alexivan04/Pong-Stabilizer/docs/report/main_english_preview.pdf

# OctoBouncer

## Dynamic Balancing and Trajectory Control System

### Authors:

## Oana Datcu

Faculty of Mechanics and Mechatronics

## Ivan Alexandru

Faculty of Automatic Control and Computer Science

### Coordinators:

## Assoc. Prof. Dr. Eng. Daniel Rosner Eng. Teodor Dicu Teaching Assist. PhD Cand. Eng. Vlad St˘anescu

### Year 2026

# Contents

1 Introduction | 1

### 2 Mechanical Design and Hardware

Implementation | 2

2.2 Chassis Integration and Component

3 Mathematical and Kinematic Modeling | 14
4 Control Strategy | 17

5 Experimental Results and Conclusions | 27

# Chapter 1

# Introduction

The problem of balancing a spherical body on a flat surface, known in the specialized literature as “Ball and Plate” [1], is one of the complex problems in the field of control systems engineering. Although at first glance it seems a simple problem, it introduces an unstable nonlinear dynamics, in which any positioning error is affected by external factors. The OctoBouncer project, having as its source of inspiration the project of the same name [2], proposes a modern approach to this paradigm, extending the limits from simple stabilization to trajectory tracking, with the dynamic control of momentum (bouncing the ball) as the long-term goal. Our objective was not only to keep the ball at a fixed point, but to transform the platform into a system capable of complex interactions, such as complex trajectories.
This achievement required close collaboration between two fundamental disciplines:
- Mechatronics: Designing a platform driven by four arms, with three degrees of freedom (pitch, roll and height), characterized by low mass and high rigidity, capable of executing sudden vertical accelerations without compromising angular precision.
- Automatic Control: Developing a distributed control system, in which high-frequency image processing (Raspberry Pi 5 [3]) is closely tied to a real-time system (Teensy 4.1 [4]) in order to estimate the state of the ball and generate commands for the motors with minimal latency.

Through OctoBouncer, we demonstrate how feedback control algorithms and image processing can be integrated into a robust physical system, capable of holding the manipulated object at a fixed point and of moving it along predefined trajectories; managing its kinetic energy as well is the next step of the project.

# Chapter 2

# Mechanical Design and Hardware Implementation

The mechanical design of the OctoBouncer system evolved through an iterative process, with structural rigidity, efficient thermal management and easy maintenance as fundamental objectives. The chosen architecture is based on a redundant parallel robotic platform, a technical solution that offers a superior dynamic response compared to standard three-support-point configurations [13]. By using four independent actuation arms, the system manages to correct positioning errors in real time, ensuring increased stability of the platform plane even during translation movements, derived from the Stewart architecture [14].

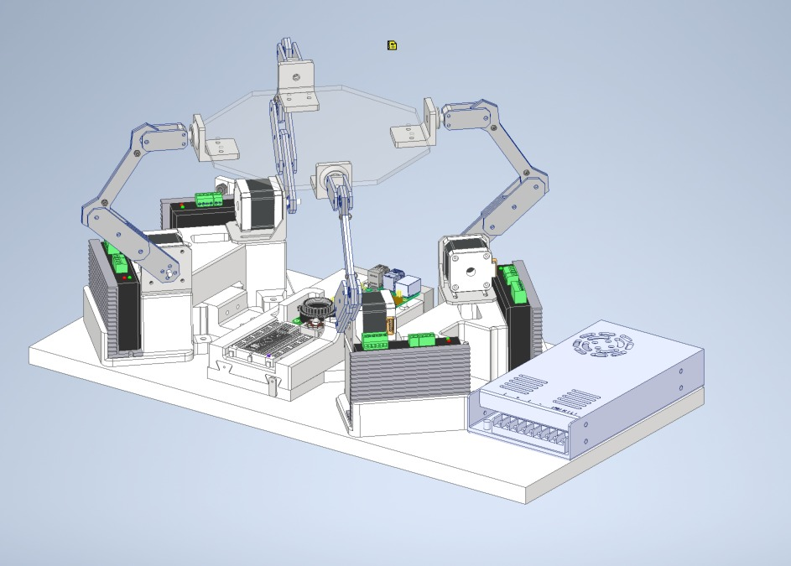
[picture p3: figure]

Figure 2.1: Isometric representation of the complete OctoBouncer system in the final design stage.

## 2.1 Anatomy of the Actuation Arm and Kinematic Optimization

The actuation arm is the most stressed component of the system, being designed to balance low mass with high mechanical strength. Its prototyping was carried out by 3D printing from PET-G [15], a material chosen for its superior impact resistance and its ability to maintain tight assembly tolerances. Each arm integrates a complex hybrid structure: one active joint connected directly to the motor and three free joints.
From a technical standpoint, the elimination of mechanical backlash was achieved by integrating precision bearings at each pivot point. This decision was critical in preventing parasitic vibrations that could have destabilized the control algorithm at high frequencies. An important innovation compared to previous versions was the introduction of an additional joint on a perpendicular plane, positioned at the point of contact with the platform. This modification solved the diagonal mobility limitations, allowing the platform to execute complex trajectories without geometric constraints.

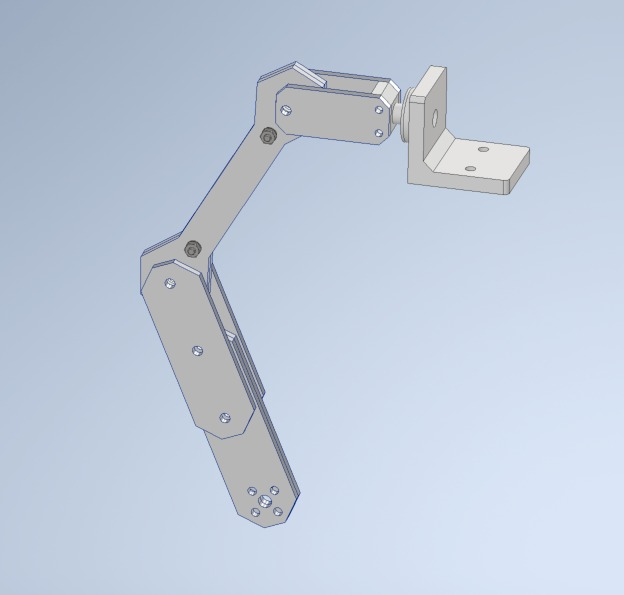
[picture p4: figure]

Figure 2.2: Arm detail: optimization of the joints and the perpendicular pivot point for extended mobility.

## 2.2 Chassis Integration and Component Management

The chassis of the system does not serve only as a structural support, but also as a casing and protection for the electronic components. The upper platform is made of 8 mm plexiglass. We opted for this thickness because it offers optimal inertia for stability, while also having elastic properties that favor the rebound function of the ball.
Beyond the mechanical aspects, a major challenge was thermal management. Stepper motors tend to generate high temperatures during prolonged operation, which could lead to structural deformation of the polymer parts. To counter this phenomenon, we used metal brackets that absorb and dissipate the motors’ heat, protecting the integrity of the PET-G base. Furthermore, the chassis design was provided with ventilation slots and dedicated air tunnels for the DM556 drivers [5], ensuring efficient active cooling under heavy loads.

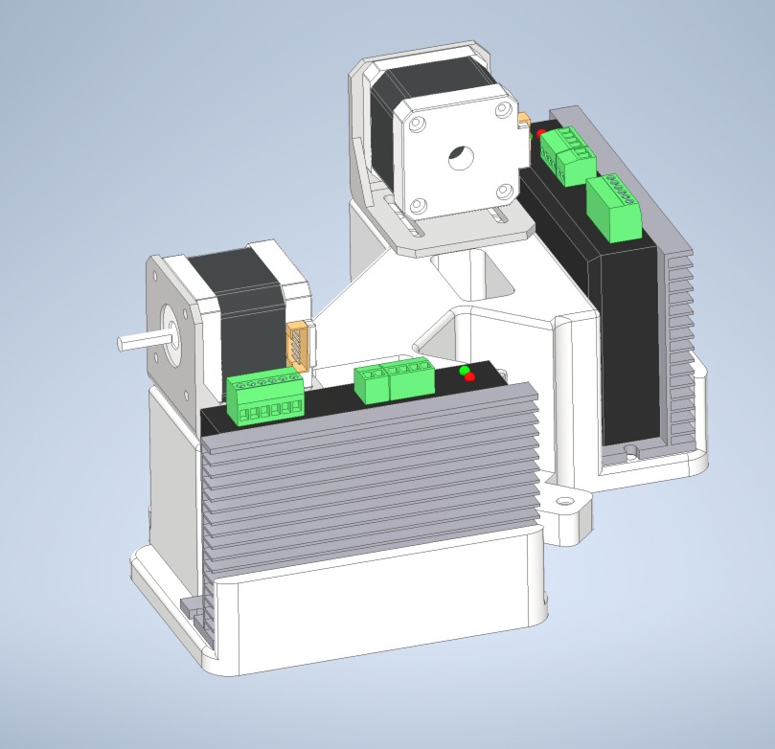
[picture p5: figure]

Figure 2.3: Internal section: airflow architecture and ergonomic layout of the power components.

Accessibility of the system was another priority in the design stage. We designed a slider-type system and interior channels for the efficient arrangement of the cables, facilitating quick access to the connections without the need to disassemble the arms. This approach reduces maintenance time and eliminates the risk of power or data wires interfering with the moving elements of the robot.

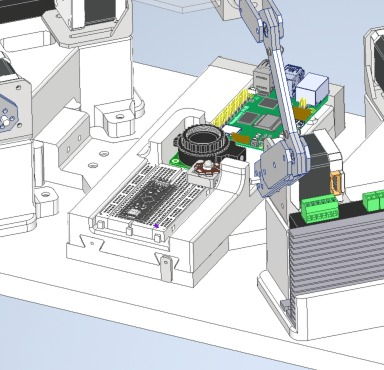
[picture p6: figure]

Figure 2.4: Detail of the sliding mechanism designed for quick access to the central computing unit and wiring.

## 2.3 Evolutionary Analysis of the Prototype

The transition from the initial version to the current OctoBouncer model involved a series of fundamental modifications. The first version suffered from low stability due to a center of mass that was too high and a lack of space for managing the wiring. The table below captures the technological evolution achieved between the two iterations.

Shortcomings of the Initial Version | Solutions Implemented in the Final Model
Robot too tall; instability under accelera-tion | Reduced profile to lower the center of mass
Difficult access to electronics; exposed wiring | Optimized chassis with slider system and protected channels
Thermal deformation of motor brackets | Integration of anti-deformation metal brackets
Limited mobility on certain axes | Addition of the perpendicular pivot joint

Table 2.1: Summary of the optimizations made to the mechanical design.

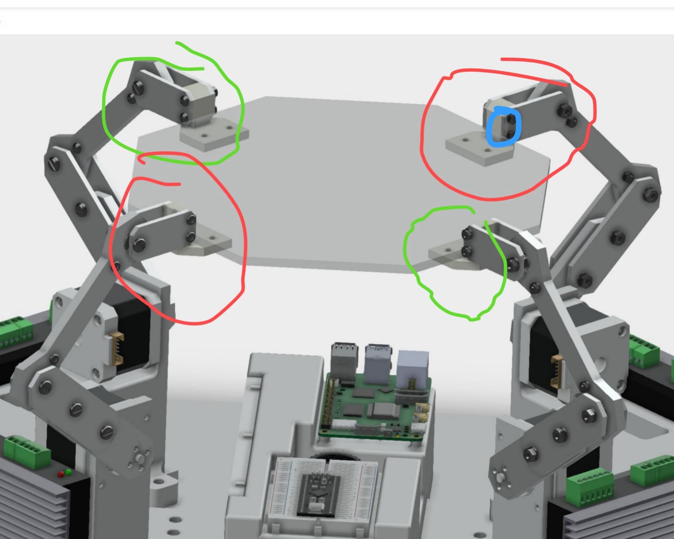
[picture p7: figure]
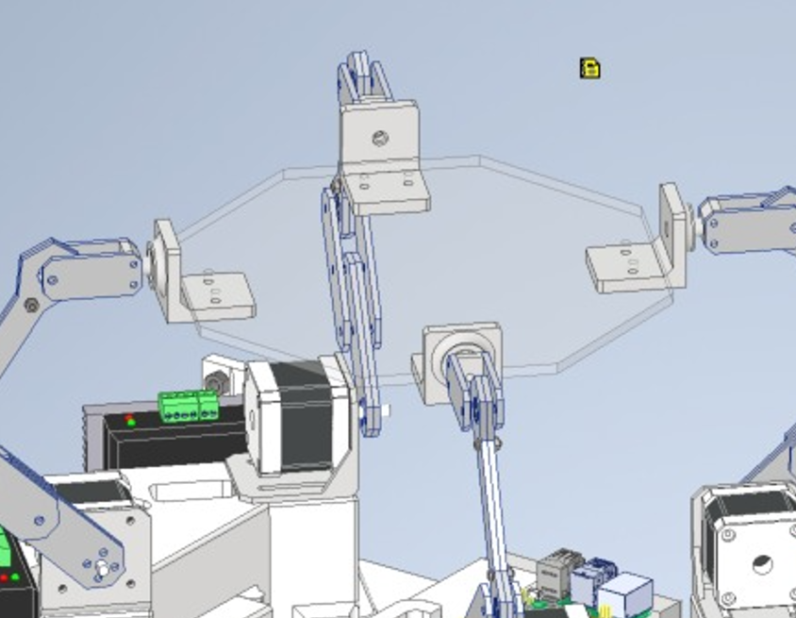
[picture p8: figure]

Figure 2.5: The initial prototype. | Figure 2.6: The OctoBouncer system.

## 2.4 Electronics and Connectivity

The electronic architecture of the OctoBouncer system was designed to ensure a minimal response time and high power supply stability, elements that are critical in the control of unstable systems. The system is built on a hierarchical structure, where the power supply for the high-power circuits and the logic one are separated in order to minimize electromagnetic interference (EMI).

### 2.4.1 Power Management

The main energy source is an efficient AC-DC unit, which provides a voltage of 48V. This value was chosen to power the power stages of the 4 DM556 drivers. The high

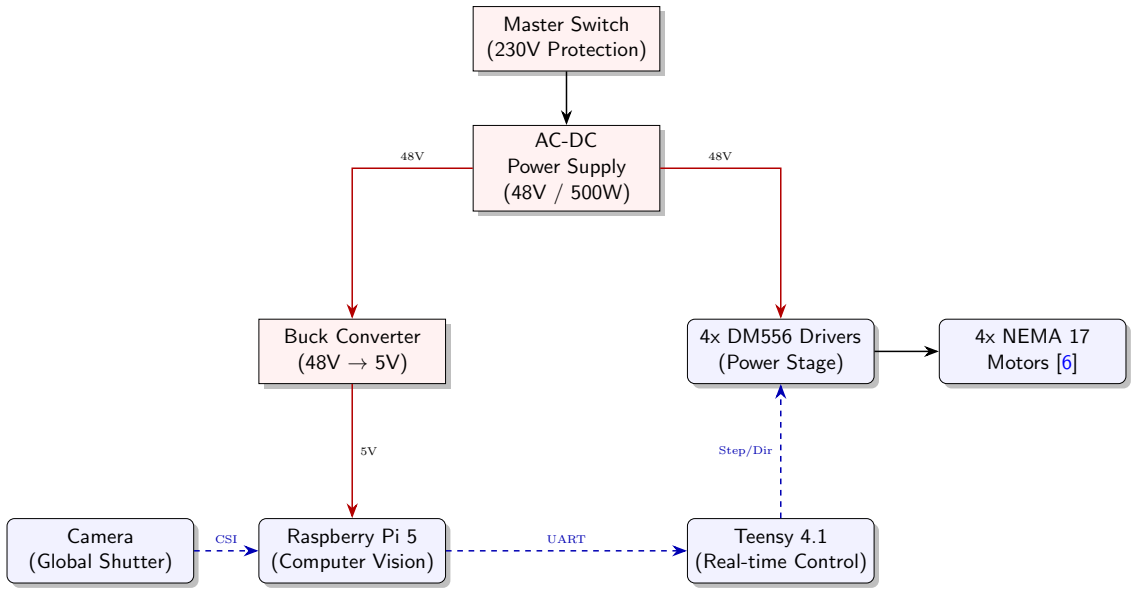
[picture p9: figure]
AC-DC Power Supply (48V / 500W); Master Switch (230V Protection); Buck Converter (48V → 5V); 4x DM556 Drivers (Power Stage); Raspberry Pi 5 (Computer Vision); Teensy 4.1 (Real-time Control); Camera (Global Shutter); 4x NEMA 17 Motors [6]; CSI; UART; Step/Dir

LED System
(Own 5V Supply)

Figure 2.7: Block diagram of the system.

voltage allows the stepper motors to reach high angular speeds and sudden accelerations, necessary for the ball’s “kick” phase, overcoming the torque limitations that usually appear at lower voltages (12V or 24V).
To power the logic subsystems, a Step-down converter lowers the voltage from 48V to 5V, in order to power the Raspberry Pi 5 and the camera. The DM556 drivers have no separate logic supply: their control electronics are powered from the 48V input.
The Teensy 4.1 (the main microcontroller) is supplied through its USB connection to the Raspberry Pi 5, which is also used to upload the firmware. The LED lighting has its own 5V step-down module, independent of the Raspberry Pi 5, and is always on. From the standpoint of safety during operation, the system integrates a high-power load switch placed directly on the input from the power supply. This switch fulfills the role of a safety barrier, allowing the instant disconnection of the entire assembly in the event of a mechanical or electrical failure, thus preventing damage to critical components or mechanical self-destruction in the event of a software error.

### 2.4.2 Actuation System and Motion Control

The control of the 4 stepper motors is carried out through industrial DM556 drivers, using Step/Dir. The motion is smoothed by configuring the drivers to a high microstepping regime (1/16, corresponding to 3200 steps/revolution). This high resolution eliminates mechanical vibrations, giving the platform millimeter-level precision in controlling the tilt plane.
Although the source code includes support for closed-loop feedback through magnetic encoders, the current version of the system uses open-loop control. The absence of encoders simplifies the wiring and reduces the computational latency, relying on the extremely stable frequency of the signal generated by the Teensy 4.1 to prevent step loss.

### 2.4.3 Communication and Data Flow

The interfacing between the two computing units is important for the best possible performance of the system:
- Camera interface: The camera communicates with the Raspberry Pi 5 through the dedicated CSI (Camera Serial Interface) port, ensuring a high-bandwidth data transfer and zero latency in the GPU’s processing buffer.
- Host-to-Controller: The Raspberry Pi 5 and the Teensy 4.1 communicate bidirectionally through the UART protocol at a speed of 115,200 baud. To guarantee the correctness of the data in an environment with electrical noise induced by the motors, a custom serial protocol was implemented. It contains the ball’s state vector (position and velocity on the 3 axes) in structured packets, validated through checksums, thus ensuring that no command is executed with corrupted data.

### 2.4.4 Electrical Schematic and Pin Assignment

Figures 2.8–2.11 show the complete electrical schematic, drawn in KiCad (the full sheet and the KiCad project are in the hardware/schematic folder of the repository). The pin numbers of the Raspberry Pi 5 are the physical pins of the 40-pin header; the pin numbers of the Teensy 4.1 are its digital pin numbers, as used in the firmware. The four motor channels are identical; the pins of each channel are given in Table 2.2.

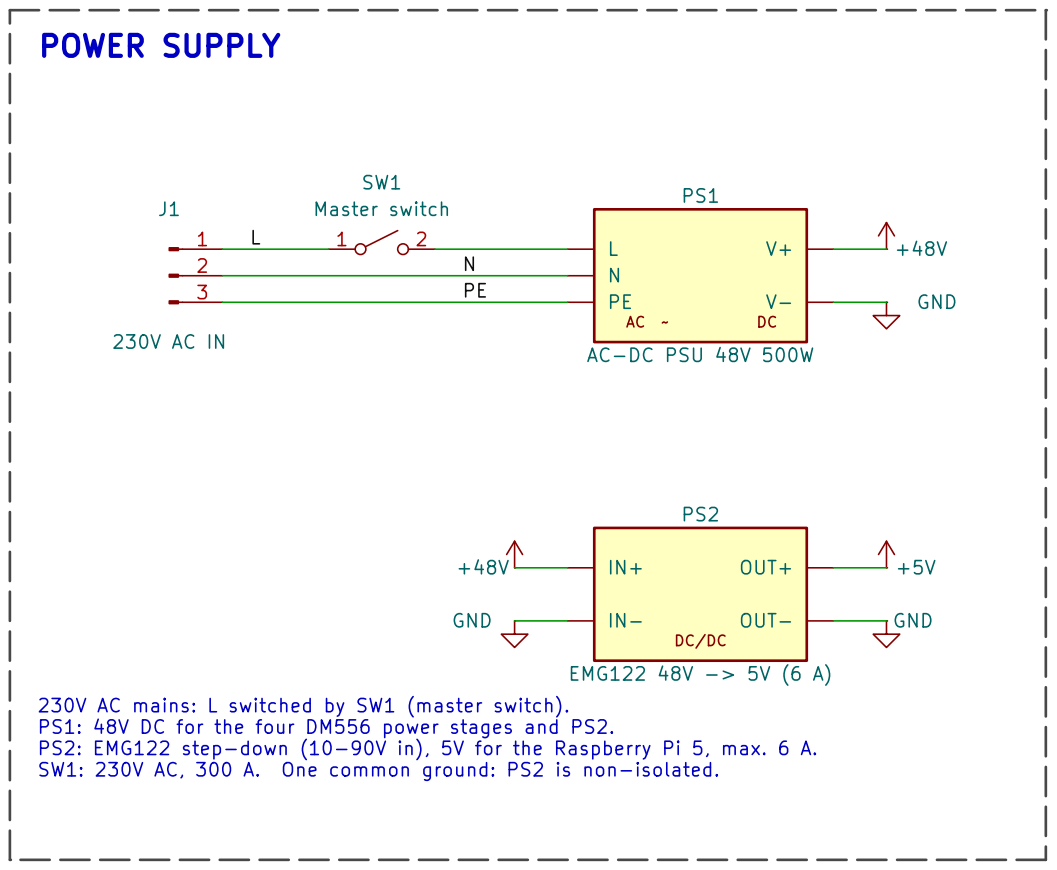
[picture p10: figure]

Figure 2.8: Electrical schematic, part 1 of 4: power supply.

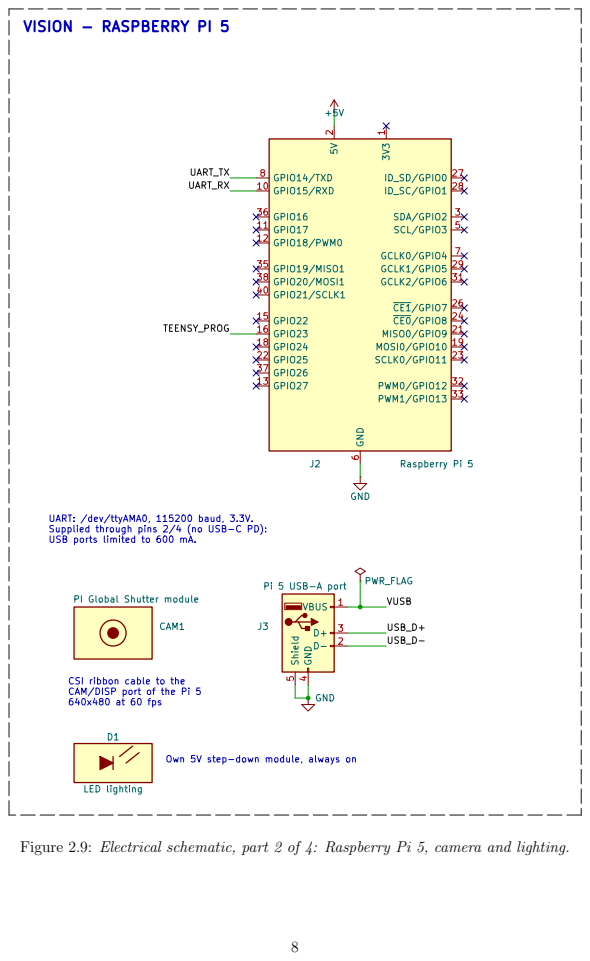
[picture p11: page 11]

Figure 2.9: Electrical schematic, part 2 of 4: Raspberry Pi 5, camera and lighting.

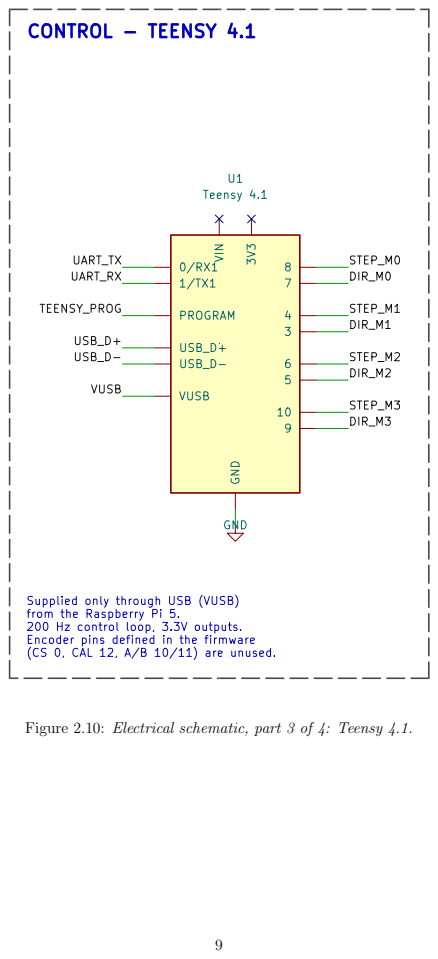
[picture p12: page 12]

Figure 2.10: Electrical schematic, part 3 of 4: Teensy 4.1.

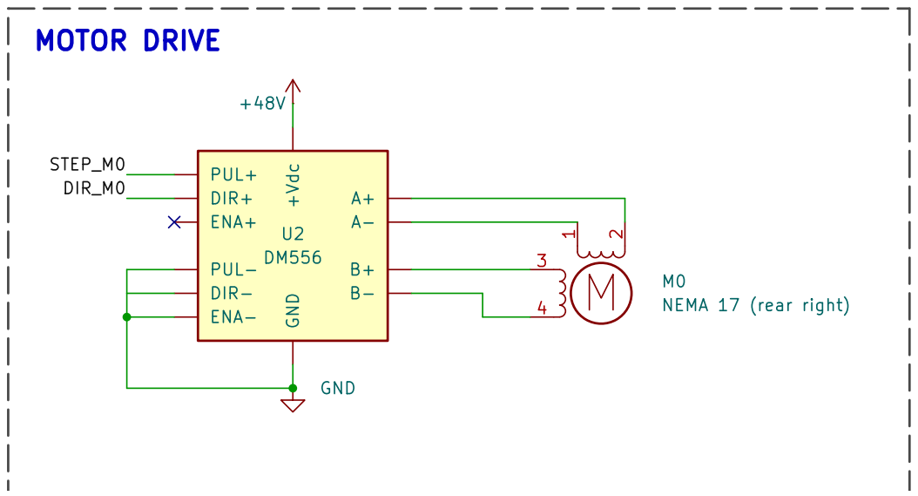
[picture p13: figure]

Figure 2.11: Electrical schematic, part 4 of 4: motor drive, channel M0. The channels M1–M3 are identical; their STEP and DIR pins are listed in Table 2.2.

Table 2.2 lists every connection of the schematic. The firmware also defines pins for the optional MT6835 magnetic encoders (CS on pin 0, CAL on pin 12, A/B on pins 10 and 11); since the encoders are not mounted in the current version, these definitions are inactive, and they would have to be moved to free pins before installing the encoders, because pin 0 is the UART receiver and pin 10 drives motor M3.

Signal | From | To | Notes
48V supply | PSU V+ / V− | DM556 +V / GND (all four), step-down IN+ / IN− | Power stage of the drivers
5V supply | Step-down OUT+ / OUT− | Pi 5 pins 2, 4 (5V) / pin 6 (GND) | Bypasses the USB-C input of the Pi
UART TX | Pi 5 pin 8 (GPIO14, TXD) | Teensy pin 0 (RX1) | /dev/ttyAMA0 → Serial1, 115,200 baud, 3.3V
UART RX | Pi 5 pin 10 (GPIO15, RXD) | Teensy pin 1 (TX1) | Direction: Teensy → Pi
Flash request | Pi 5 pin 16 (GPIO23) | Teensy PROGRAM | Puts the Teensy in bootloader mode
USB | Pi 5 USB-A | Teensy micro-USB | Only power source of the Teensy (5V), common ground, firmware upload
Camera | Pi 5 CSI port | Camera module | Ribbon cable
Lighting | Separate 5V step-down module | LED system | Independent of the Raspberry Pi 5, always on
STEP M0 / DIR M0 | Teensy pins 8 / 7 | DM556 M0 PUL+ / DIR+ | Motor M0, rear right
STEP M1 / DIR M1 | Teensy pins 4 / 3 | DM556 M1 PUL+ / DIR+ | Motor M1, front right
STEP M2 / DIR M2 | Teensy pins 6 / 5 | DM556 M2 PUL+ / DIR+ | Motor M2, front left
STEP M3 / DIR M3 | Teensy pins 10 / 9 | DM556 M3 PUL+ / DIR+ | Motor M3, rear left
Signal return | DM556 GND terminal | PUL−, DIR− and ENA− of each driver | Common-cathode wiring; the return reaches the Teensy ground through the common ground of the non-isolated step-down converter
Enable | – | DM556 ENA+ | Not connected (ENA− on GND): drivers always enabled
Motor phases | DM556 A+, A−, B+, B− | Motor coil A, coil B | One driver per motor

Table 2.2: Pin assignment of the electrical connections.

### 2.4.5 Component Ratings

Table 2.3 lists the electrical ratings of the components. The DM556 values are taken from the manufacturer’s manual [5], the Teensy 4.1 values from the PJRC specifications [4], and the Raspberry Pi 5 values from the product brief [3].

Component | Rating | Use in the system
AC-DC PSU | Output 48V DC, 500 W (max. 10.4 A) | Supplies the four drivers and the step-down converter
Master switch | 230V AC, 300 A, waterproof, ignition-protected | Disconnects the 230V AC input
Step-down converter | OEM EMG122 buck module: input 10–90V, output 1.5–60V (set to 5V), max. 6 A / 100 W, efficiency up to 97.5 % | Supplies the Raspberry Pi 5 (5 A recommended); non-isolated, so its input and output share the ground
Raspberry Pi 5 | 5V DC, 5 A recommended (27 W); GPIO 3.3V, not 5V tolerant | Image processing, UART master
Teensy 4.1 | 5V via USB, on-board 3.3V regulator; I/O 3.3V, not 5V tolerant | 200 Hz control loop, STEP/DIR generation
DM556 driver (×4) | Supply 20–50V DC; output 1.8–5.6 A peak, set to 2.7 A RMS (3.8 A peak) with the DIP switches; isolated logic inputs, 5V nominal | Microstepping 1/16 (3200 pulses/revolution)
NEMA 17 motor (×4) | ◦/step (200 Bipolar, 1.8 steps/revolution), rated 1.5 A per phase, 5 mm shaft [6] | Arm actuation
Camera | Raspberry Pi Global Shutter Camera (Sony IMX296 sensor) with fisheye lens, CSI, used at 640 × 480 and 60 fps | Ball detection
LED lighting | 5V, from its own step-down module | Constant illumination, always on

Table 2.3: Electrical ratings of the components.

Three aspects of these ratings are relevant for the operation of the system:

- Supply voltage margin: The 48V bus is close to the 50V maximum of the DM556 drivers. During fast deceleration the motors return energy to the bus, so the voltage can briefly rise above the nominal value; the margin of 2V should be kept in mind if the power supply is replaced.
- Logic levels: The optically isolated inputs of the DM556 are specified for 5V signals, while the Teensy 4.1 outputs 3.3V. In the current system they are connected directly; a 3.3V → 5V level shifter would restore the nominal input current of the optocouplers.

- Raspberry Pi 5 supply through the GPIO header: Because the Pi 5 is supplied through pins 2 and 4, it does not negotiate its power with a USB-C supply, and by default it limits the total current of its USB ports to 600 mA. This is sufficient for the Teensy 4.1, which is the only USB device.

# Chapter 3

# Mathematical and Kinematic Modeling

The kinematic model of the OctoBouncer system has the role of establishing a precise correlation between the Cartesian coordinate space (the position and orientation of the platform) and the joint space (the rotation angles of the 4 stepper motors). For this project, we implemented an inverse kinematics model based on the geometry of parallel systems with 4 support points, using the mathematical basis specific to parallel robots [13], derived from the architecture of the Stewart manipulator [14].

## 3.1 Geometric Parameters of the System

In the geometric calculations, we used the following constant dimensions, determined through CAD design and direct measurements:

- L1 (98.1 mm): Length of the arm fixed on the motor shaft.
- L2 (92.0 mm): Length of the transmission rod (intermediate link).
- L3 (54.0 mm): Vertical offset created by the joint under the platform.
- Rb (129.0 mm): Radius of the fixed base (distance from the center to the motor axis).
- Rp (110.0 mm): Radius of the mobile platform (distance from the center to the spherical joint).
- h0 (100.0 mm): Neutral operating height of the platform.

## 3.2 Inverse Kinematics Calculation

The purpose of the algorithm is to determine the motor angle αi

for each arm
i ∈ {0, 1, 2, 3}, starting from the orientation angles θpitch (pitch) and θroll (roll).

### 3.2.1 Determining the Position of the Anchor Points

Each motor is positioned at an angle γi relative to the central axis, defined in the source code as:
γ = {225◦

, 135◦

, 45◦

, 315◦
} | (3.1)

For a given orientation of the platform, the vertical height Zi of each joint on the platform is calculated by projecting the tilt angles onto the radial geometry:

Zi = h0 + Rp · (sin(θroll) · cos(γi) + sin(θpitch) · sin(γi)) | (3.2)

Taking into account the length of the joint L3, the vertical target for the transmission rod becomes Ztarget = Zi − L3.

### 3.2.2 Solving the Arm Geometry (Law of Cosines)

Solving the inverse kinematics for parallel manipulators is done by decomposing the system into independent kinematic loops (closed-loop vector equations) [13]. The problem reduces to a triangle formed in the vertical plane of each motor. The radial distance between the point on the base and the one on the platform is constant in horizontal projection:

Xof fset = |Rb − Rp| | (3.3)

The direct distance D between the motor axis and the spherical joint on the platform is:
D =

q
X²
of fset + Z

2
target | (3.4)

Applying the Law of Cosines in the triangle formed by L1, L2 and D, we obtain the interior angle β:
β = arccos
L

2

1 + D² − L

2
2
2 · L1 · D
(3.5)

The final rotation angle of the motor, αi

, is the sum of the base geometric angle and the correction β:
αi = arctan 2(Ztarget, Xof fset) + β | (3.6)

## 3.3 Implementation in the Control Loop

The complete model above is implemented in the firmware (the calculateArmAngle function) and describes the geometry of the mechanism. In the current version of the real-time loop, however, it is not called: for the small tilts needed for balancing, the relation between the tilt of the platform and the rotation of each arm is close to linear, so the controller uses a linear mixing of the two tilt commands. The PID outputs θpitch and θroll (Chapter 4) are expressed directly in degrees of arm rotation, and each arm receives:

αi = αh + σ

p
i

θpitch + σ

r
i
θroll | (3.7)

with the signs (σ

p
i

, σr
i

) equal to (+1, +1), (−1, +1), (−1, −1) and (+1, −1) for the motors M0 (rear right), M1 (front right), M2 (front left) and M3 (rear left), where αh is the common arm angle that sets the height of the platform (Section 4.7). A positive pitch command thus raises the rear arms and lowers the front ones, and a positive roll command raises the right side. All angles αi are measured from the mechanical low stop of the arms. This simplification avoids the trigonometric calculations in the 200 Hz loop; the gains of the PID controller absorb the constant ratio between arm rotation and platform tilt.

## 3.4 Mechanical Limitations and Constraints

For reasons of structural safety and to prevent collisions between links or the locking of joints (singularities), we implemented a strict software limitation of the tilt commands:

−12◦ ≤ θpitch,roll ≤ 15◦
(3.8)

In addition, every arm command is limited to the range 5◦ ≤ αi ≤ 40◦ above the low stop, so that the arms never press against the stop, and the common height angle αh is kept between 17◦ and 30◦

, which leaves 12◦ of tilt range below and 10◦ above. With only 10◦ below (the earlier setting), the lower arm reached its limit as soon as pitch and roll together asked for more than 10◦
, and stopped reacting.
These constraints keep the system in a zone of relative linearity and prevent the motors from being forced into extreme positions. At the moment, the bouncing function is disabled in order to protect the integrity of the rod-joint assembly under heavy dynamic loads, as it has not yet been tested sufficiently.

# Chapter 4

# Control Strategy

The control system of the OctoBouncer is distributed between two processing units, the final goal being to keep the ball in the center of the platform (or to follow a trajectory) by continuously adjusting the tilt plane.

## 4.1 Distributed Control Architecture

To maximize performance, we separated the processing tasks into two levels:

1. High Level: The Raspberry Pi 5 runs the image processing algorithms under OpenCV, extracting the (x, y) coordinates of the ball and calculating the velocity vectors (Vx, Vy) at a high frequency.
2. Execution Level: The Teensy 4.1 receives the data through UART and runs the PID control loop at a frequency of 200 Hz (5 ms), generating the Step/Dir signals for the motors.

## 4.2 PID Control Algorithm

The core of the stabilization is a Proportional-Integral-Derivative (PID) controller [11]. The calculation formula for the desired tilt angle (on each axis) is:

θ(t) = Kp · e(t) + Ki

·

Z t

0

e(τ )dτ + Kd · (Vball(t) − Vtarget(t)) | (4.1)

where e(t) is the difference between the filtered position of the ball and the target position. Where the components fulfill the following roles:

- Proportional Term (Kp): Reacts instantaneously to the ball’s position error relative to the target (the center of the platform or the current point of the trajectory).
- Integral Term (Ki): Eliminates steady-state errors caused by possible mechanical imperfections or residual tilts of the base. We implemented an anti-windup limitation of the integral to prevent saturation of the integrator.
- Derivative Term (Kd): Acts as a “brake” (damping). The velocities of the ball and of the target are estimated on the Teensy by differentiating their EMA-filtered positions (Section 4.4) and smoothing the result with a second EMA filter (α = 0.2), which attenuates the numerical noise of the differentiation [12]. The term acts on the velocity of the ball relative to the target: a ball that moves together with a moving target is not braked, while with a fixed target (CENTER mode) the term reduces to a derivative on the measurement, which avoids command jumps when the target changes. The velocity estimated by the Raspberry Pi is also transmitted, but is not used by the controller. Section 5.7 compares this form with a derivative acting on the ball’s own velocity.

## 4.3 Real-Time Image Processing Subsystem (Raspberry Pi)

The high level of the control architecture is implemented as a Python script running continuously on the Raspberry Pi 5, which can be launched automatically at startup. Its responsibility is to transform the stream of frames from the camera into a complete state vector of the ball, made up of three-dimensional position and velocities, transmitted in real time to the Teensy 4.1. The subsystem code is organized modularly, each script fulfilling a distinct role in the development and operation flow of the system.

### 4.3.1 Camera Calibration with Fisheye Lens

The camera used is a Raspberry Pi Global Shutter Camera: its sensor exposes all pixels at the same time, so a fast-moving ball is not distorted as with a rolling shutter. It is equipped with a fisheye (ultra-wide angle) lens, which, although it maximizes the field of view in order to cover the entire surface of the platform, introduces a pronounced radial distortion. Straight lines appear curved, and objects at the edge of the frame are scaled non-uniformly relative to the center. Using raw pixel coordinates in the position calculations would introduce unacceptable systematic errors into the control loop.
The calibration process takes place in two steps implemented in the camera calib module:
1. Capturing the calibration images (1 capture images.py): A checkerboard pattern with a grid of 9 × 7 squares (8 × 6 interior corners) is used. The operator presents the board in front of the camera at various angles and distances, saving one frame at each press of the ’s’ key, at the moment when the findChessboardCorners algorithm [16] visually confirms the complete detection. The calibration set used comprises 31 images, covering sufficient spatial variations to characterize the distortion across the entire sensor area.
2. Calculating the intrinsic parameters (2 calibrate calc.py): Based on the set of images, the cv2.fisheye.calibrate algorithm from OpenCV [7] is run, which determines the camera’s intrinsic matrix K and the fisheye distortion vector [8, 9] D (with 4 coefficients). The correction of the corners is carried out through cornerSubPix to a precision of 0.001 pixels. The resulting parameters are saved in a binary Numpy array file, cam calib fisheye.npz, loaded at every system startup.

Based on these parameters, two rectification tables (map1, map2) are generated through the cv2.fisheye.initUndistortRectifyMap function. The cv2.remap function applies a bilinear rectification on each captured frame, efficiently transforming the initial fisheye projection into a distortion-free plane-perspective image. The parameter balance = 1.0 ensures that the entire field of view is preserved without cropping, at the cost of some black edges at the corners.

### 4.3.2 Ball Color Calibration (1 tune color.py)

The detection of the ball is based on color segmentation in the HSV space [10], chosen instead of RGB for decoupling the hue information from lighting variations. Before the first use, or whenever the ball, the light source or the ambient environment changes, the interactive color calibration script must be run.
The graphical interface exposes six sliders, corresponding to the lower thresholds [Hmin, Smin, Vmin] and to the upper thresholds [Hmax, Smax, Vmax]. The values are adjusted in real time while simultaneously observing the original image and the resulting binary mask, with the aim of maximizing the white area corresponding to the ball and eliminating any false positives from the background. The camera is configured in manual mode (without auto-exposure and without automatic white balance), with the exposure time set to 20 ms (limited by the camera to the frame period of 16.7 ms at 60 fps) and the analog gain at 2.0. Upon pressing the ’q’ key, the calibrated values are saved in the hsv values.txt file and will be loaded automatically at subsequent startups.

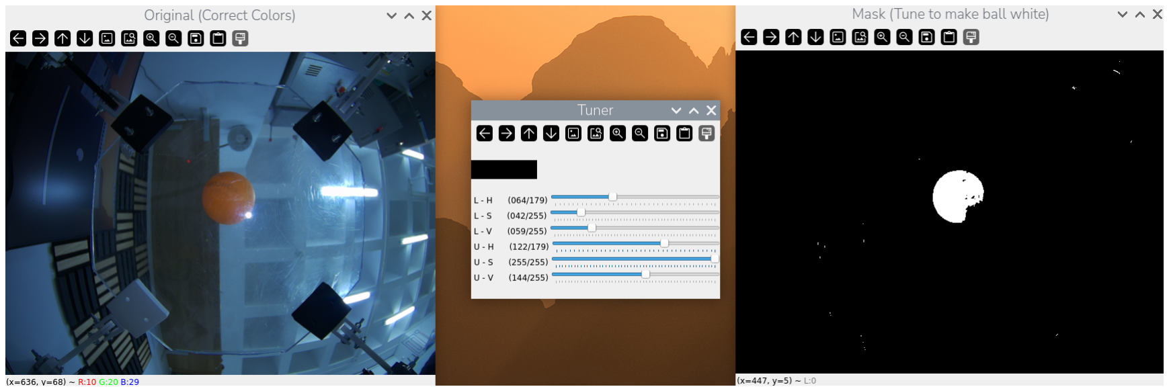
[picture p14: figure]

Figure 4.1: The HSV calibration interface: the original window (left), the slider panel with the current thresholds (center) and the resulting binary mask - the ball appears white, the background black (right).

### 4.3.3 Processing Pipeline and State Estimation

The main processing loop, implemented in 4 headless track.py (without display, for autonomous operation) and 4 gui track.py (with display, for monitoring and diagnostics), successively goes through the stages described below at an acquisition frequency of 60 fps, a resolution of 640 × 480 pixels, through the dedicated CSI interface of the Raspberry Pi 5.

1. Capture and geometric correction: The BGR frame is captured directly through the Picamera2 library [17] in native format, avoiding an additional color conversion. The precomputed fisheye rectification is applied immediately.
2. HSV segmentation and morphological operations: The corrected image is converted into the HSV space, and the binary mask is obtained through a color threshold. An erosion followed by a dilation with a 3 × 3 kernel is applied to the mask, eliminating point artifacts without affecting the geometry of the ball.
3. Contour selection and radius estimation: The cv2.findContours function extracts all the connected regions from the mask. The contour with the maximum area is selected as the sole candidate. The cv2.minEnclosingCircle function determines the center (xpx, ypx) and the radius rpx in pixels. A minimum threshold filter rpx > 5 eliminates false detections caused by reflections or other surrounding objects with similar hues.
4. 3D reconstruction through the corrected pinhole model: The depth Z is estimated from the apparent diameter of the ball in the geometrically corrected image, using an extended pinhole model with angular correction to compensate for the perspective elongation effect at the edges of the image:

Zpinhole =

fx · Dreal
2 · rpx

, Zf inal = Zpinhole ·

s
1 +
dcenter
fx

2
(4.2)

where Dreal = 40 mm is the real diameter of the ball, fx is the focal length extracted from the new camera matrix K′
, and dcenter is the distance in pixels from the optical center. The planar coordinates in millimeters are calculated through inverse projection:

Xreal =

(xpx − cx) · Zf inal
fx

, Yreal =

(ypx − cy) · Zf inal
fy

(4.3)

5. Plate-centered coordinates: The positions are finally expressed relative to the center of the plate, which lies (8.0, −1.2) mm from the optical center of the camera (measured once from markers on the brackets, with the plate level). The CENTER target and all patterns are therefore centered on the plate.
6. Median filtering of the depth: Because Xreal and Yreal are proportional to Zf inal, a single-frame error in the estimated radius would move the ball position and produce a false velocity. The depth is therefore passed through a median filter: the median of the last 15 frames (0.25 s) is used to scale X and Y , and the median of the last 5 frames is reported as Z. The median removes isolated outliers without smoothing real movements as strongly as an average.

### 4.3.4 Velocity Estimation and Two-Stage Filtering

Since the velocity of the ball cannot be obtained through direct measurement, it is estimated numerically. Differentiating the positions between consecutive frames amplifies the quantization errors, requiring a two-level filtering for noise attenuation:

1. Filtering the raw position (EMA with αpos = 0.6): Before computing the derivative, the raw positions are filtered. A higher α means that the system tracks the ball quickly, but passes more noise to the velocity estimation.
2. Filtering the calculated velocity (EMA with αvel = 0.15): The resulting numerical velocity is passed through an aggressive low-pass filter. The value αvel = 0.15 was determined experimentally: higher values (> 0.4) leave residual vibrations that destabilize the derivative term of the PID, while lower values (< 0.05) introduce a noticeable phase delay at sudden changes of direction.

These velocities are displayed in the diagnostic interface and transmitted to the Teensy, which computes its own estimate for the controller (Chapter 4). An additional deadband mechanism (1.5 mm) treats displacements that are below the threshold as null, eliminating false velocities under stationary-ball conditions. If the ball disappears from the field of view, the velocity is decremented exponentially (factor 0.8 per frame) instead of being reset abruptly, preventing command shocks at re-detection.

### 4.3.5 Tuning Parameters

The optimal functioning of the frame capture and processing subsystem depends on the correct calibration of the parameters grouped in the following table. They are adjustable both by directly modifying the source files and at runtime through the dedicated graphical interfaces.

Parameter | Current value | Impact when adjusted
[Hmin, Smin, Vmin] | [98, 145, 40] | Too narrow: detection losses; too wide: false posi-tives from the environment
[Hmax, Smax, Vmax] | [116, 255, 255] | Upper limit of the accepted color; Smax and Vmax at 255 include the entire brightness range
rpx,min (minimum radius) | 5 px | Below this value, the de-tection is ignored; prevents false positives from reflec-tions
αpos (position EMA) | 0.6 | Higher values: fast tracking, but more noise toward the velocity estimator
αvel (velocity EMA) | 0.15 | Compromise between atten-uating the derivative noise and the response latency at impact
Deadband | 1.5 mm | Eliminates velocity drift at rest; too large masks real slow movements
balance (undistort) | 1.0 | 0.0 = central crop without black edges; 1.0 = maxi-mum field of view preserved

Table 4.1: Configuration parameters of the visual detection subsystem and their effect on the behavior of the system.

### 4.3.6 Live Visualization and Diagnostic Interface

The versions with display (4 gui track.py, 4 gui track w mode.py) overlay a diagnostic layer on top of the corrected video stream, intended exclusively for tuning and debugging. The overlay displays the ball detection status (FOUND/LOST), the spatial coordinates (X, Y, Z) and the velocities (Vx, Vy, Vz) in real time, the green circle superimposed on the detected ball, the current operating mode of the system, as well as a real-time animation in the bottom-right corner.

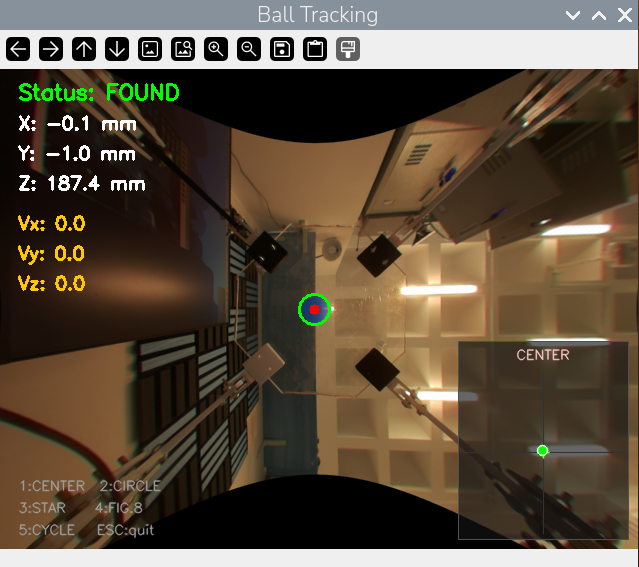
[picture p15: figure]

Figure 4.2: The GUI interface in CENTER mode: the ball is kept in the center of the platform, and the minimap indicates the target position (green) relative to the actual position of the ball (yellow).

### 4.3.7 Trajectory Generator and Pattern Selection

In addition to stabilization at a fixed point, the OctoBouncer system implements a trajectory generator that forces the ball to follow predefined geometric shapes. The active mode is controlled bidirectionally through the UART protocol: the Teensy 4.1 notifies the Raspberry Pi at each pattern transition, and the user can change the mode from the graphical interface by pressing the keys 1–5, without any need for a direct modification in the code.
Four distinct trajectories are defined, plus an automatic cycling mode:
- CENTER (key 1): The ball is kept at the origin of the platform. The target is fixed at (0, 0).
- CIRCLE (key 2): The ball follows a circular trajectory with a radius of 50 mm and a period of 5 s.
- STAR (key 3): A 5-pointed star-shaped trajectory, alternating between the outer radius of 60 mm and the inner one of 25 mm, with a period of 10 s.
- FIGURE 8 (key 4): A figure-eight-type trajectory (lemniscate), with a horizontal semi-axis of 60 mm and a vertical one of 30 mm, with a period of 6 s.

- CYCLE ALL (key 5): The system automatically cycles through all four modes above, 25 s each, with smooth transitions ensured by a target rate limiter of 120 mm/s.

Two further patterns, STEP X and STEP Y, are used only by the automated test protocol (Chapter 5): the target jumps between −30 and +30 mm along one axis every 8 s, through the same rate limiter.
The synchronization of the visualization with the real execution is ensured by transmitting the current target position (tx, ty) from the Teensy to the Raspberry Pi through a dedicated PACKET TYPE TARGET POS packet at every 5 ms iteration. Thus, the green dot in the animation reflects exactly the coordinate followed by the PID controller.

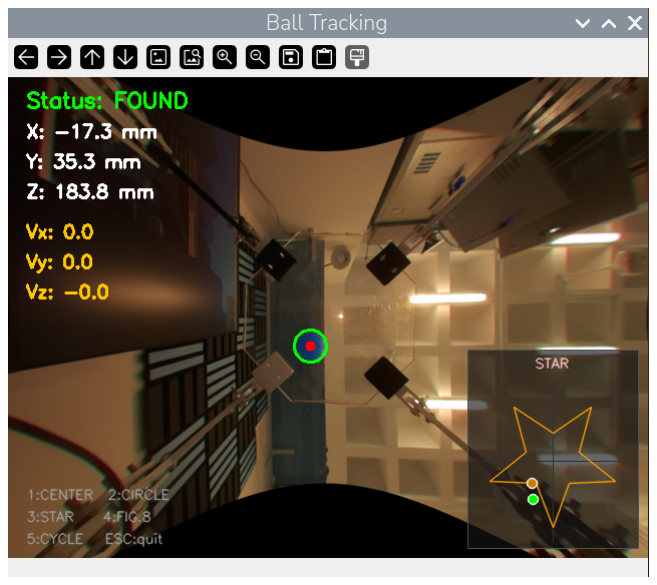
[picture p16: figure]
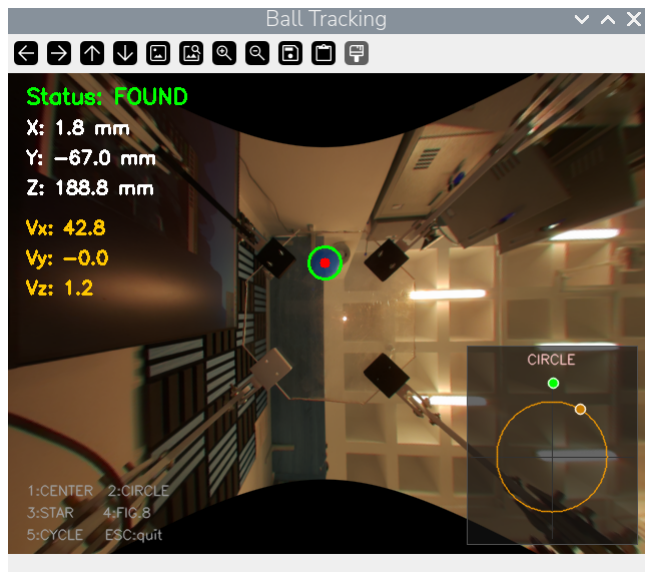
[picture p17: figure]
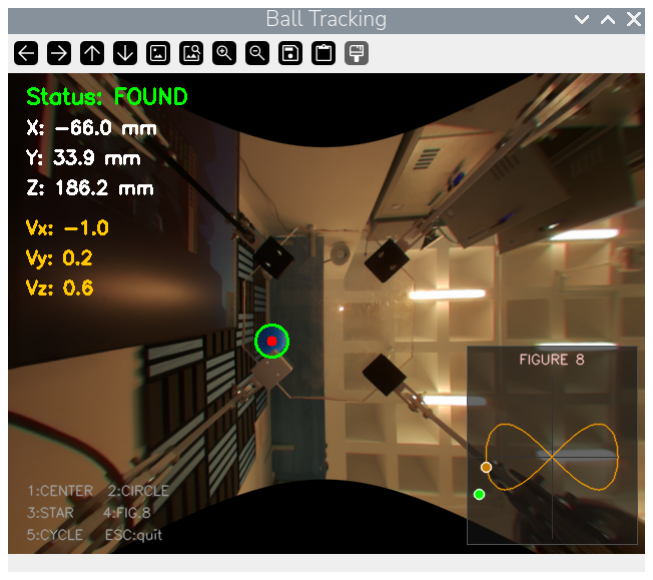
[picture p18: figure]

Figure 4.3: CIRCLE mode. | Figure 4.4: STAR mode. | Figure 4.5: FIG8 mode.

### 4.3.8 Real-Time PID Tuning Interface

The 4 gui track pid.py script extends the diagnostic interface with three sliders that allow adjusting the coefficients Kp, Ki and Kd in real time, without restarting the system. The sliders start from the default values hardcoded in the firmware (Kp = 0.149, Ki = 0.112, Kd = 0.068, for positions expressed in the units of the HSV pipeline; see Section 5.1). The values are scaled internally by the factor 1
| | 1000 and are transmitted to
the Teensy through a dedicated packet of type PACKET TYPE PID UPDATE once the user modifies any slider. The current coefficients are also displayed in the video overlay (in light green, under the velocities section).

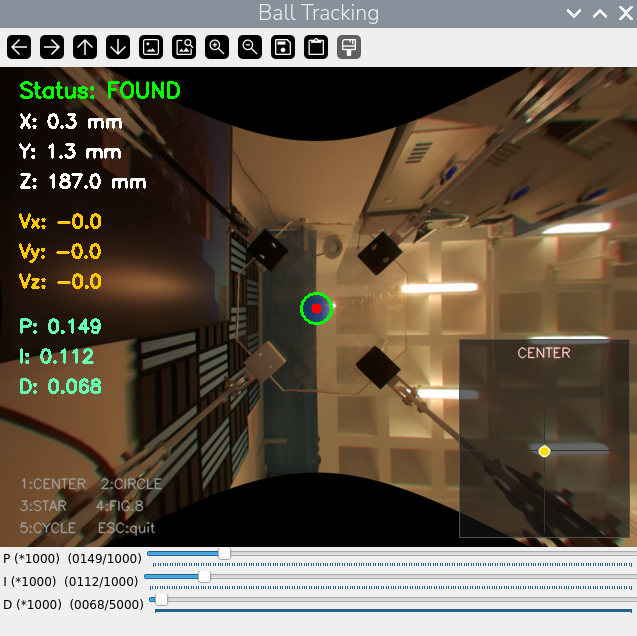
[picture p19: figure]

Figure 4.6: The PID tuning interface: the P, I, D sliders visible in the lower part of the window, with the current values displayed in the overlay (light green). Pattern selection remains available through the keys 1–5.

### 4.3.9 Serial Communication Protocol

At the end of each processing cycle, the ball’s state vector is serialized and transmitted through UART at 115,200 baud. The implemented custom protocol has the structure:

0xAA | {z }

start

| TYPE | {z }

packet type

| SIZE | {z }

length

| PAYLOAD | {z }

data

| CSUM | {z }

XOR

| 0xBB | {z }

stop

(4.4)

The checksum is calculated as an accumulated XOR over the packet type, the size and each byte of the payload. The checksum is validated on the Teensy before the data is introduced into the PID loop; a corrupted packet is ignored, and the system continues with the last valid state. Five packet types are defined: BALL DATA (the positions X, Y, Z and the velocities Vx, Vy, Vz packed as 6 32-bit floats, with a status byte is found), PID UPDATE (three floats with the new coefficients), START (initialization signal), PATTERN CHANGE (mode change, bidirectional) and TARGET POS (the current target position and the height setting of the platform, transmitted by the Teensy to the Pi at every 5 ms iteration for the synchronization of the minimap). The Teensy reads only the position and the detection status from BALL DATA.

## 4.4 Data Filtering (EMA Filter)

The received position data may exhibit white noise due to the camera resolution or lighting variations. To normalize the system’s response without introducing significant latencies, we used an EMA (Exponential Moving Average) filter [19]:

Xf iltrat = α · Xraw + (1 − α) · Xanterior | (4.5)

The value α = 0.15 was chosen experimentally to balance noise attenuation with the reaction speed of the system. The target position is passed through an identical filter before its velocity is computed, so that the two velocities compared in the derivative term have the same delay.

## 4.5 Real-Time Management and Synchronization

The stability of a “Ball and Plate” system depends on the constancy of the sampling period. The Teensy 4.1 uses a high-precision internal clock to ensure the execution of the control loop at exactly 5 ms. The firmware is written in C++ and built with PlatformIO [18].

- If the data from the Raspberry Pi is delayed, the system uses the last known state to maintain stability.
- The motor movement is interpolated to avoid mechanical shocks, ensuring a smooth transition between the calculation steps of the PID.

## 4.6 Safety Limitations (Software Constraints)

To protect the mechanical structure, the angles calculated by the PID are passed through a limiting block before being converted into arm commands (Section 3.3), and every arm command is limited to its safe range. This prevents reaching the mechanical limits of the joints in the case of violent movements or if the ball accidentally leaves the platform.
An edge guard protects the ball itself: when it moves more than 85 mm from the center of the plate, close to the edge and to the screws of the brackets, the target is moved back to the center (through the rate limiter) until the ball is again within 40 mm; then the pattern continues.

## 4.7 Plate Height Control

The arm angles are measured from the mechanical low stop, so the arms must rest on the stop when the Raspberry Pi sends the START command. At startup the Teensy lifts all arms to 5◦

in 1 s, then raises them together at 2◦/s to 17◦ while the balancing loop is already active, so the ball can be placed on the platform immediately.
From there, the common height angle αh is controlled from the measured depth of the ball: since the camera is under the platform, a higher platform increases Z. The Teensy keeps the ball at Z = 195 ± 4 mm by moving αh at 0.05◦/s per millimeter of error, at most 2◦/s, within the range 17◦–30◦
. The depth is low-pass filtered and only used while the ball is within 75 mm of the center, where its estimate is reliable. The height setting is reported to the Raspberry Pi in the TARGET POS packet.

# Chapter 5

# Experimental Results and Conclusions

## 5.1 Experimental Method

We measured the performance of the OctoBouncer on the physical system in two test campaigns. Both use the final control configuration: median-filtered depth, a derivative term acting on the velocity of the ball relative to the target, and closed-loop control of the plate height.

- Campaign A (24 October 2026): four runs (runs 7–10) in the automatic cycling mode (CYCLE ALL), in which the controller follows each pattern for 25 s: CENTER, CIRCLE, STAR and FIGURE 8. The ball was placed on the plate at start-up and the system was not touched afterwards. A fifth run (run 1), recorded with the same vision system but before the control changes (derivative term on the ball’s own velocity, depth not filtered), serves as the reference for the comparison of the two derivative terms in Section 5.7.
- Campaign B (25 October 2026): an automated test protocol (5 test runner.py) ran five times in a row, 42.6 min and 153,380 frames at 60 fps in total. Each run consists of 60 s in CENTER, 64 s of target steps along each axis (Section 5.4), 60 s of each pattern and five light taps on the ball held in CENTER (Section 5.5). Every test starts from the ball at rest after 10 s in CENTER, so all transitions are the same. The ball fell off once and was put back; the interrupted phase was repeated automatically.

Campaign B differs from campaign A in three details, introduced between the two: the positions are relative to the center of the plate instead of the camera (Section 4.3), the edge guard is active, and the tilt range is that of Section 3.3 (in campaign A: −10◦

to 15◦
,
and a minimum height of 15◦
). Only the final derivative term was tested in campaign B. In these runs the ball positions are expressed in true millimeters. The HSV pipeline of Section 4.3 reports about 1/1.4 of the true distances, because the dilated mask overestimates the apparent radius of the ball; the PID gains of Chapter 4 were therefore divided by the same factor 1.4, so that the controller behaves identically.
For every camera frame (60 Hz) the tracking script on the Raspberry Pi 5 logs the measured ball position pball(t) and the target ptarget(t) that the Teensy 4.1 reports through the TARGET POS packet every 5 ms, i.e. exactly the set-point used by the PID controller. All coordinates are in millimeters, relative to the camera’s optical center in campaign A and to the center of the plate in campaign B. In campaign B every frame also carries its exposure time (the camera’s SensorTimestamp); the ball position is evaluated at that instant and the target is interpolated to it, so the delay between exposure and processing

(25.3 ms, median) does not appear as lag. The tracking error is defined as:

e(t) = ∥pball(t) − ptarget(t)∥ | | (5.1)

The following quantities were computed for each pattern phase:

- Steady-state error: The mean, RMS, 95th percentile (P95) and maximum of e(t) over the last 15 s of each 25 s phase. The final 0.5 s of each phase are excluded, because the target already moves towards the next pattern.
- Settling time (ts): The time after the pattern switch from which the 1 s moving RMS of e(t) stays below 1.1 times the largest 1 s moving RMS observed in the steady-state window. A value of zero means that the switch produced no error transient larger than the pattern’s own steady-state error.
- Lag: The time shift of the measured path that minimizes its mean squared distance to the target (positive: the ball is behind the target; negative: ahead of it).
- Shape deviation and amplitude ratio: The mean distance of the measured path from the ideal curve, and the ratio between the ball’s mean distance from the center and the target’s.
- Step response (campaign B): for each 60 mm step, the rise time from 10 to 90 % of the step, the delay between the 50 % points of target and ball, the overshoot, and the settling time to ±5 % of the step (3 mm) and to ±2 mm, measured from the start of the target ramp.
- Disturbance rejection (campaign B): the largest distance of the ball from the center after a tap, and the time until it stays within 5 mm of the center for at least 1 s.

In campaign B the steady state of the patterns is the window from 20 to 60 s after the start, and CENTER is evaluated from 5 s after the start.
Two checks support the validity of the measurement. First, the commanded target coincides with the mathematical trajectories of Section 5.2 (maximum deviation 0.07 mm), so the target rate limiter is not active in steady state and the comparison with the ideal curves is exact. Second, while the ball is held at the center, the high-frequency scatter of the measured position (deviation from its 0.25 s moving average) is 0.57 ± 0.12 mm RMS, an order of magnitude below the tracking errors reported below. The ball path is measured by the same vision system that closes the control loop; no independent ground-truth sensor was available.

## 5.2 Trajectory Tracking

The target trajectories are defined in the firmware of the Teensy 4.1 as:

CIRCLE: xt = 50 cos(ωt), yt = 50 sin(ωt), | ω = 2π/5 rad/s | (5.2)
FIGURE 8: xt = 60 sin(ωt), yt = 30 sin(2ωt), | ω = 2π/6 rad/s | (5.3)

and, for the STAR, as straight segments between ten vertices at the angles φi = π/2 +iπ/5 with radii alternating between 60 mm and 25 mm, covering one vertex per second (period 10 s). All values are in millimeters.

Figure 5.1 compares these curves with the measured ball paths in steady state, and Figure 5.2 shows the same data as time series.

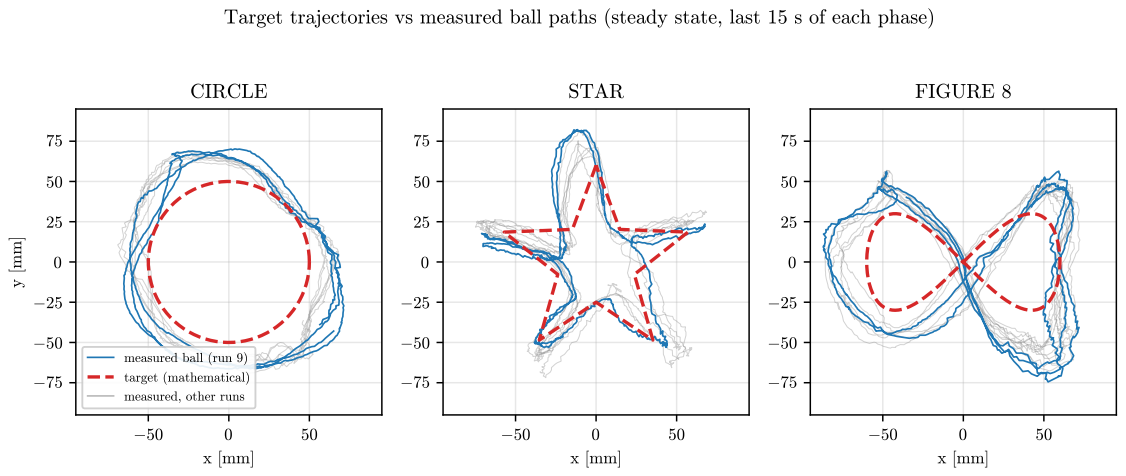
[picture p20: figure]
CIRCLE; measured, other runs; STAR; FIGURE 8

measured ball (run 9) target (mathematical)

Target trajectories vs measured ball paths (steady state, last 15 s of each phase)

Figure 5.1: Target trajectories (red, dashed) and measured ball paths in steady state (last 15 s of each phase). Blue: run 9; gray: runs 7, 8 and 10.

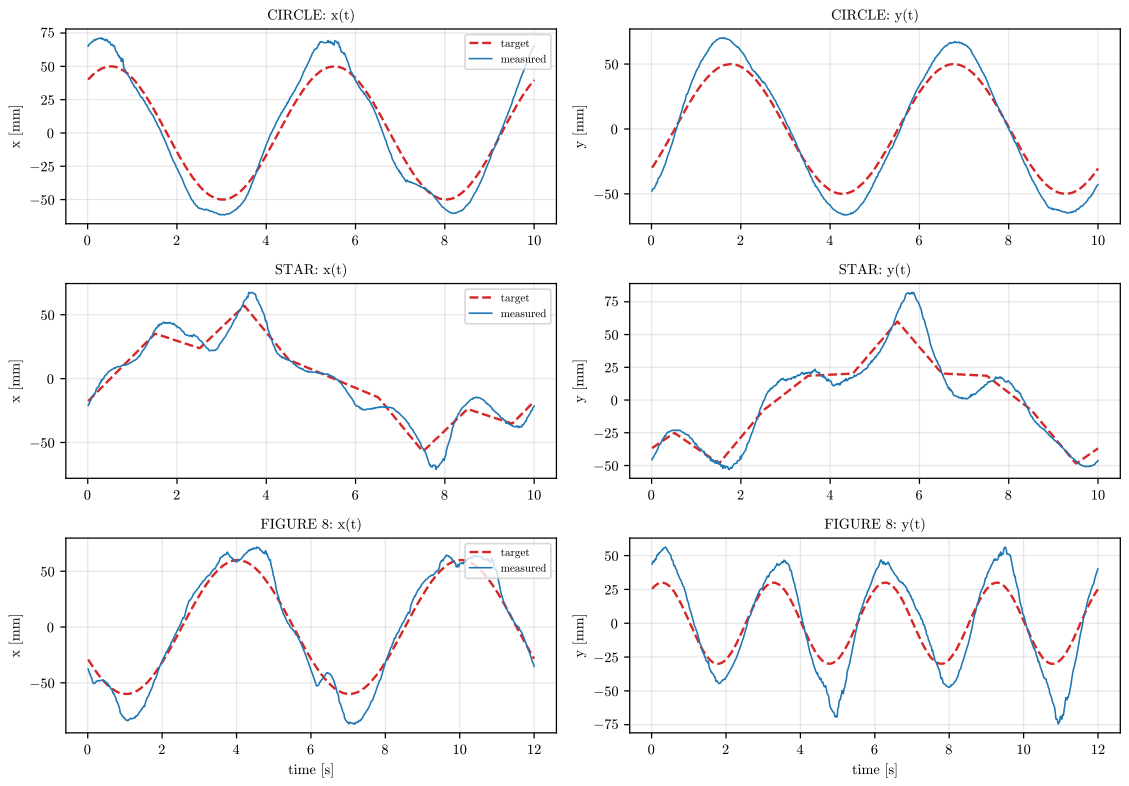
[picture p21: figure]
CIRCLE: x(t); target; measured; CIRCLE: y(t); STAR: x(t); STAR: y(t); time [s]; FIGURE 8: x(t); FIGURE 8: y(t)

Figure 5.2: Target (red, dashed) and measured (blue) coordinates over time, run 9, steady state.

The ball follows all three shapes with almost no time lag (Table 5.1): 0.05 s on the figure 8 and 0.10 s on the star, while on the circle it is even 0.04 s ahead of the target

(negative lag). This is a consequence of the derivative term acting on the velocity relative to the target: it reacts to the motion of the target itself and produces a phase lead, which compensates the delay of the plate and of the ball. The price of this lead is an overshoot in amplitude, so the remaining error is mostly geometric: the ball travels on a path that is larger than the target, by 25 % on the circle and 31 % on the figure 8, overshooting outwards where the curvature is highest. The star, made of straight segments covered at low speed, is followed most faithfully: its measured path stays on average 7.4 mm from the ideal shape and is only 9 % larger, the extra displacement appearing mainly at the outer vertices.

Pattern | Lag [s] | RMS without lag [mm] | Shape devia-tion [mm] | Amplitude ra-tio
CIRCLE | −0.04 ± 0.01 | 15.0 ± 1.6 | 12.8 ± 1.6 | 1.25 ± 0.03
STAR | 0.10 ± 0.02 | 13.5 ± 0.7 | 7.4 ± 0.6 | 1.09 ± 0.01
FIGURE 8 | 0.05 ± 0.02 | 18.5 ± 1.4 | 13.7 ± 1.1 | 1.31 ± 0.03

Table 5.1: Decomposition of the tracking error on the moving patterns: time lag, error without the lag, deviation from the ideal shape and amplitude ratio.

Campaign B repeats the three patterns five times each, always starting from the ball at rest (Table 5.2, Figure 5.3). The mean errors, 14.2 mm (circle), 14.6 mm (star) and 16.5 mm (figure 8), are practically those of campaign A, and the spread between the five runs is only 0.5–1.0 mm. With the exposure time of each frame the lag is free of the camera delay: the ball is 0.08 s ahead of the target on the circle, 0.11 s behind on the star and 0.03 s behind on the figure 8; the amplitude ratios (1.24, 1.09 and 1.29) confirm the outward deviation found in campaign A.

Metric | CIRCLE | STAR | FIGURE 8
Settling time [s] | 2.1 ± 1.4 | 1.6 ± 3.2 | 0.5 ± 1.1
Mean error [mm] | 14.2 ± 0.5 | 14.6 ± 1.0 | 16.5 ± 0.6
Mean error without screw contacts [mm] | 14.2 ± 0.5 | 14.5 ± 1.1 | 15.7 ± 0.8
P95 error [mm] | 23.4 ± 1.0 | 27.8 ± 2.0 | 28.8 ± 1.3
Lag [s] | −0.08 ± 0.01 | 0.11 ± 0.02 | 0.03 ± 0.01
Amplitude ratio | 1.24 ± 0.01 | 1.09 ± 0.02 | 1.29 ± 0.01
Shape deviation [mm] | 12.2 ± 0.5 | 7.3 ± 0.5 | 12.6 ± 0.4
Screw contacts per run | 0.4 ± 0.5 | 2.0 ± 1.1 | 12.4 ± 2.9

Table 5.2: Trajectory tracking in campaign B (5 runs per pattern, each started from the ball at rest in CENTER); steady state 20–60 s; lag from the exposure time of each frame (camera delay removed); without screw contacts: excluding 0.3 s around each contact.

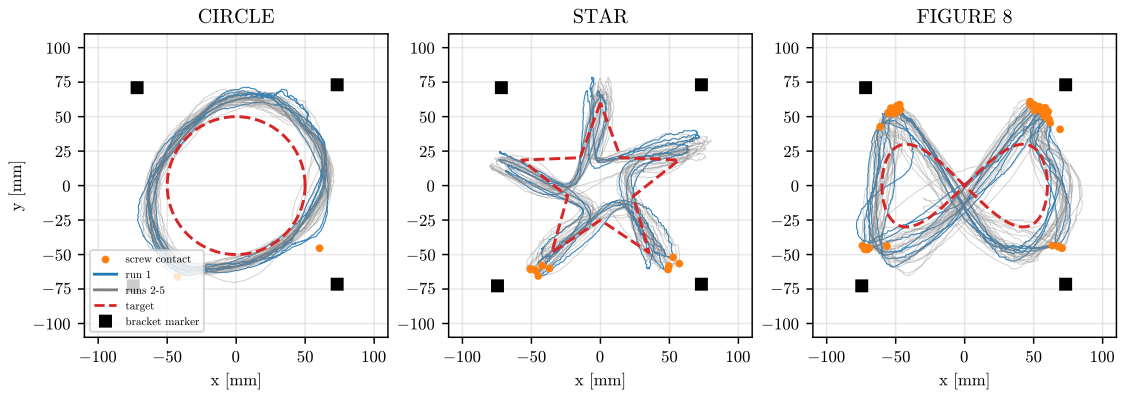
[picture p22: figure]
CIRCLE; screw contact run 1; runs 2-5 target bracket marker; STAR; FIGURE 8

Figure 5.3: Campaign B: target trajectories (red, dashed) and measured ball paths in steady state, run 1 (blue) and runs 2–5 (gray), with the detected screw contacts (orange) and the bracket markers (black).

## 5.3 Settling Time and Steady-State Error

Table 5.3 summarizes the settling time and the steady-state tracking error. Figure 5.4 shows the error over a complete pattern cycle, and Figure 5.5 the behavior after switching to CENTER.

Pattern | Runs | Settling [s] | Mean [mm] | RMS [mm] | P95 [mm] | Max [mm]
CENTER | 3 | 4.6 ± 4.1 | 2.9 ± 1.5 | 3.4 ± 1.8 | 7.0 ± 4.0 | 8.4 ± 4.2
CIRCLE | 3 | 2.2 ± 0.7 | 14.2 ± 1.5 | 15.3 ± 1.5 | 24.3 ± 1.2 | 29.1 ± 1.9
STAR | 4 | 2.4 ± 1.8 | 12.5 ± 0.9 | 14.4 ± 1.0 | 26.7 ± 2.8 | 33.8 ± 3.4
FIGURE 8 | 4 | 0 | 17.1 ± 1.2 | 18.9 ± 1.5 | 30.6 ± 5.3 | 41.7 ± 6.5

Table 5.3: Settling time and steady-state tracking error of the final configuration (mean ± standard deviation over the runs).

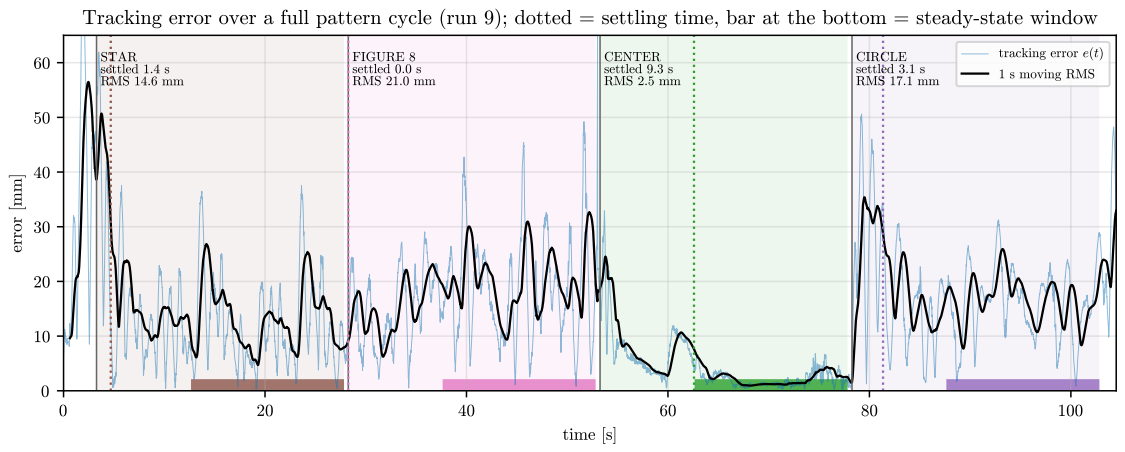
[picture p23: figure]
time [s]; error [mm]; STAR; FIGURE 8; CENTER; CIRCLE; tracking error e(t)

settled 1.4 s RMS 14.6 mm | settled 0.0 s RMS 21.0 mm | settled 9.3 RMS 2.5 mm | s | settled 3.1 s RMS | 1 s moving RMS 17.1 mm

Tracking error over a full pattern cycle (run 9); dotted = settling time, bar at the bottom = steady-state window

Figure 5.4: Tracking error over one complete pattern cycle (run 9). Thin line: e(t); thick line: 1 s moving RMS; dotted lines: settling time of each phase; colored bars at the bottom: steady-state window.

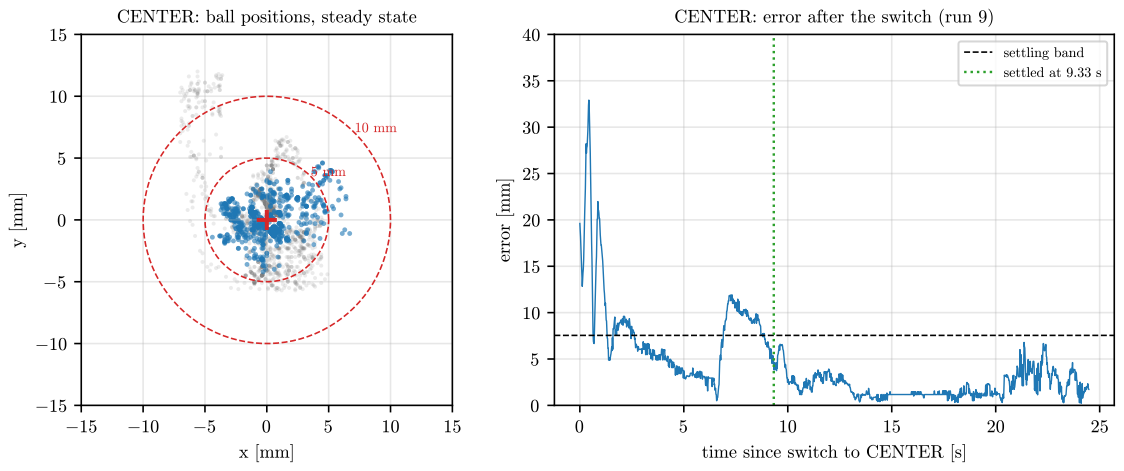
[picture p24: figure]
CENTER: ball positions, steady state; time since switch to CENTER [s]; error [mm]; CENTER: error after the switch (run 9); settling band settled at 9.33 s

Figure 5.5: CENTER mode. Left: ball positions in steady state (blue: run 9, gray: runs 7 and 8). Right: tracking error after the switch to CENTER in run 9, with the settling band.

When the target is fixed at the center, the ball is held with a mean error of 2.9 ± 1.5 mm. In steady state it stays within 5 mm of the center in 97 % and 96 % of the samples in runs 8 and 9, and in 65 % in run 7, where it stays within 10 mm in 90 % of the samples. The transition into CENTER (the target returns from the previous pattern at the 120 mm/s rate limit) settles in 2.1 s and 2.5 s in runs 7 and 8. In run 9 the settling time is 9.3 s, because of a single excursion of about 12 mm, 7 s after the switch (Figure 5.5, right), whose cause was not identified; for this reason the per-run values are listed in Table 5.5 in addition to the mean. Switching to CIRCLE or STAR settles within 2.2 ± 0.7 s and 2.4 ± 1.8 s. Switching from STAR to FIGURE 8 produced no transient beyond the figure 8’s own steady-state error in any of the four runs.
On the moving patterns the steady-state error is 12.5 mm (star), 14.2 mm (circle) and 17.1 mm (figure 8) on average, with 95 % of the samples below 26.7, 24.3 and 30.6 mm respectively. The spread between runs is small (standard deviation

0.9–1.5 mm on the mean error), which indicates that these values are repeatable. The ball was detected in 100 % of the analyzed frames.
In campaign B, started from the ball at rest, the patterns settle within 2.1 ± 1.4 s (circle), 1.6±3.2 s (star) and 0.5±1.1 s (figure 8). In CENTER the ball is held with a mean error of 2.3 ± 0.7 mm and stays within 5 mm of the center during 92 ± 6 % of the time (81–100 % in the individual runs), with a measurement noise of 0.33 mm (Table 5.4). The lower error than in campaign A (2.9 mm) is consistent with the plate-centered coordinates, which hold the ball in the middle of the plate instead of 8 mm to the side of it.
Runs | Mean [mm] | RMS [mm] | P95 [mm] | Max [mm] | Within 5 mm | Noise [mm]
5 | 2.3 ± 0.7 | 2.8 ± 0.8 | 5.6 ± 1.7 | 9.1 ± 3.5 | 92 ± 6 % | 0.33 ± 0.07

Table 5.4: CENTER hold after the ball was placed at rest (60 s per run, first 5 s excluded).

Run | Pattern | Settling [s] | Mean [mm] | RMS [mm] | P95 [mm] | Max [mm]
7 | CENTER | 2.08 | 4.7 | 5.5 | 11.6 | 13.2
7 | CIRCLE | 1.78 | 13.5 | 14.5 | 23.3 | 27.8
7 | STAR | 5.05 | 11.6 | 13.2 | 23.4 | 29.7
7 | FIGURE 8 | 0.00 | 15.8 | 17.4 | 26.5 | 33.6
8 | CENTER | 2.45 | 1.9 | 2.4 | 4.7 | 5.3
8 | CIRCLE | 1.85 | 13.2 | 14.4 | 23.8 | 28.4
8 | STAR | 1.75 | 13.8 | 15.5 | 27.9 | 32.4
8 | FIGURE 8 | 0.00 | 17.4 | 19.0 | 28.4 | 40.9
9 | CENTER | 9.33 | 2.1 | 2.5 | 4.7 | 6.8
9 | CIRCLE | 3.08 | 16.0 | 17.1 | 25.7 | 31.3
9 | STAR | 1.41 | 12.2 | 14.6 | 29.9 | 37.6
9 | FIGURE 8 | 0.00 | 18.6 | 21.0 | 38.4 | 49.2
10 | STAR | 1.50 | 12.4 | 14.1 | 25.6 | 35.4
10 | FIGURE 8 | 0.00 | 16.5 | 18.2 | 29.1 | 43.3

Table 5.5: Settling time and steady-state tracking error for each run.

## 5.4 Step Response

Figure 5.6 and Table 5.6 show the response to 74 target steps of 60 mm (from −30 to +30 mm and back, every 8 s, 37 along each axis). Because of the rate limiter each step is a 0.5 s ramp of the target. The ball follows quickly: it rises from 10 to 90 % of the step in

### 0.35 s and is only 0.18 s behind the target at the midpoint. However, it overshoots the

new position by 56–62 % of the step (about 35 mm) and then returns with a damped oscillation. The median settling time to within ±5 % (3 mm) is 3.0 s (X) and 3.7 s (Y), reached within the 8 s hold by about 60 % of the steps; for the tighter ±2 mm band only 27–35 % of the steps settle within the hold, the others keep oscillating by a few millimeters, with a mean remaining error of 1.8 mm. The motion along the other axis stays small (2.7–3.5 mm RMS).

Metric | STEP X | STEP Y
Steps | 37 | 37
Rise time 10–90 % [s] | 0.35 ± 0.05 | 0.36 ± 0.04
Delay at 50 % [s] | 0.18 ± 0.03 | 0.18 ± 0.02
Overshoot | 56 ± 10 % | 62 ± 10 %
Settling time to ±5 % (3 mm) [s], median | 3.0 (settled: 59 %) | 3.7 (settled: 62 %)
Settling time to ±2 mm [s], median | 4.5 (settled: 27 %) | 5.9 (settled: 35 %)
Remaining error, last 2 s [mm] | 1.8 ± 1.0 | 1.8 ± 1.5
Other axis, RMS [mm] | 2.7 ± 1.1 | 3.5 ± 1.4

Table 5.6: Step response to 60 mm target steps in campaign B (rate-limited to 120 mm/s, i.e. a 0.5 s ramp); times from the start of the target ramp; settled: share of the steps that settled within the 8 s hold.

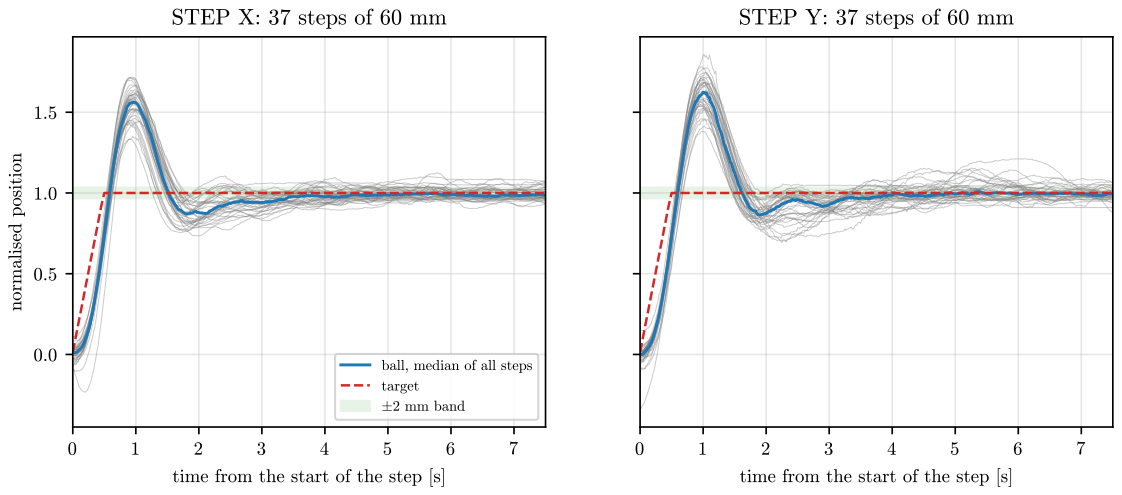
[picture p25: figure]
time from the start of the step [s]; normalised position; STEP X: 37 steps of 60 mm; ball, median of all steps target §2 mm band; STEP Y: 37 steps of 60 mm

Figure 5.6: Step responses of campaign B, normalized to the 60 mm step: all steps (gray), their median (blue), the rate-limited target (red, dashed) and the ±2 mm band (green).

## 5.5 Disturbance Rejection

At the end of each run of campaign B the ball, held in CENTER, was pushed sideways by hand five times, every 8 s. Of the 25 taps, 22 moved the ball clearly (more than about 8 mm) and were analyzed (Table 5.7, Figure 5.7). The ball was displaced by 40.9 ± 13.7 mm on average (up to 87 mm), reached its largest distance 0.44 s after the tap, swung back once past the center, and was again within 5 mm of the center 3.8 ± 1.2 s after the tap (20 of the 22 taps within the 7.5 s analyzed). None of the taps threw the ball off the plate. The taps were given by hand, so their strength varies; the results describe the recovery from a light push, not from a defined impulse.

Taps | Detected | Peak deviation [mm] | Time to peak [s] | Recovery to 5 mm [s]
25 | 22 | 40.9 ± 13.7 | 0.44 ± 0.27 | 3.83 ± 1.21

Table 5.7: Disturbance rejection: a light sideways tap on the ball while held in CENTER (5 per run).

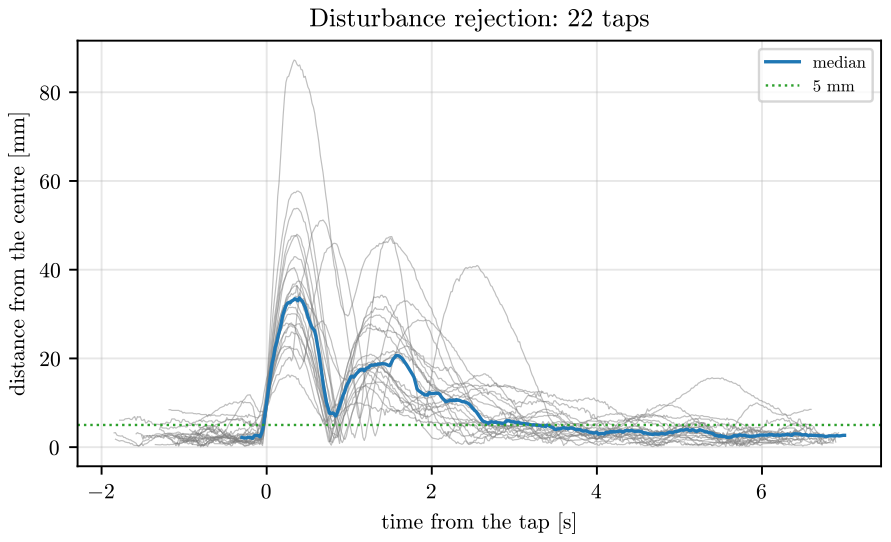
[picture p26: figure]
time from the tap [s]; distance from the centre [mm]; Disturbance rejection: 22 taps; median 5 mm

Figure 5.7: Distance of the ball from the center after each of the 22 analyzed taps (gray) and their median (blue).

## 5.6 Screw Contacts and Ball Losses

The plate is held by four brackets, each with two screws whose heads stand above the surface; seen from the camera they lie on the diagonals, about 103 mm from the center. When the ball touches a screw its velocity changes abruptly, while the controller changes it smoothly. We counted a contact when the ball’s velocity changed by more than 100 mm/s between two consecutive windows of 5 frames (83 ms each), at least 65 mm from the center and within 15◦ of a bracket direction; detections less than 0.2 s apart count as one. Without the direction condition, 83 % of such abrupt changes beyond 65 mm lie near a bracket, while the ball spends only 48 % of its time at that distance there, which confirms that the criterion detects contacts and not control actions.
In the 42.6 min of campaign B we counted 75 contacts (Figure 5.8): 62 in FIGURE 8 (12.4 ± 2.9 per 60 s phase), 10 in STAR, 2 in CIRCLE and one at rest. They occur where the enlarged lobes of the figure 8 reach the brackets, about 75 mm from the center (Figure 5.3), and one bracket accounts for 34 of them. Their effect on the tracking error is small: excluding 0.3 s around each contact lowers the mean error of the figure 8 from 16.5 to 15.8 mm (Table 5.2).
The ball left the plate only once in 42.6 min, at the start of a FIGURE 8 phase. It left sideways, along the x-axis (−4

◦
, away from the brackets), without a contact in the 2 s before. The edge guard, which moved the target to the center during about 1 % of the STAR and FIGURE 8 phases, did not prevent this loss.

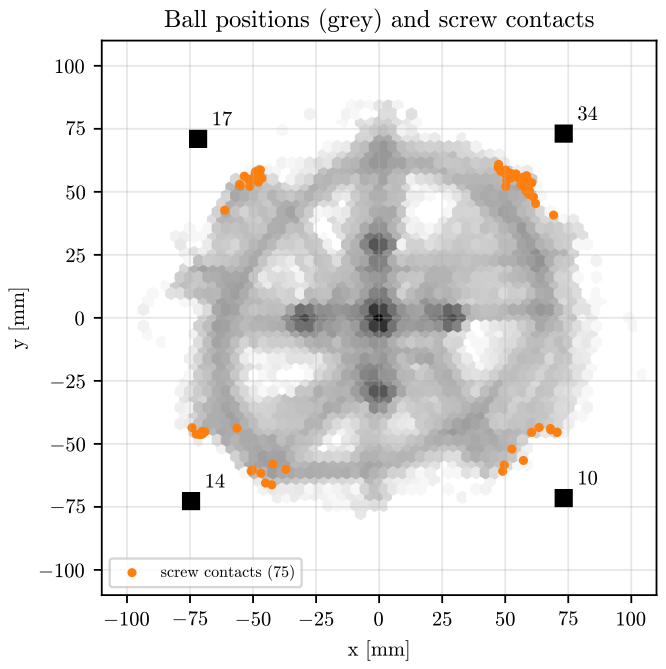
[picture p27: figure]
screw contacts (75)

Ball positions (grey) and screw contacts

Figure 5.8: Campaign B: all ball positions (gray, logarithmic density), the 75 detected screw contacts (orange) and the number of contacts at each bracket marker (black).

## 5.7 Effect of the Control Changes

Table 5.8 and Figure 5.9 compare the final configuration with run 1. Before the changes, the derivative term reacted to the ball’s own velocity, and therefore also braked a ball that was correctly following a moving target. The ball lagged the target by 0.37–0.43 s and its path was 25–48 % larger than the target. Making the derivative act on the velocity relative to the target, and filtering the depth used to scale the position, removed most of this lag and reduced the mean tracking error by 36–61 % on the moving patterns and by 34 % at the center.

Pattern | Before: mean / P95 [mm] | After: mean / P95 [mm] | Mean error reduc-tion
CIRCLE | 36.3 / 44.9 | 14.2 / 24.3 | 61 %
STAR | 19.7 / 41.4 | 12.5 / 26.7 | 36 %
FIGURE 8 | 36.7 / 55.4 | 17.1 / 30.6 | 53 %
CENTER | 4.4 / 7.6 | 2.9 / 7.0 | 34 %

Table 5.8: Steady-state tracking error before (run 1) and after (runs 7–10) the control changes.

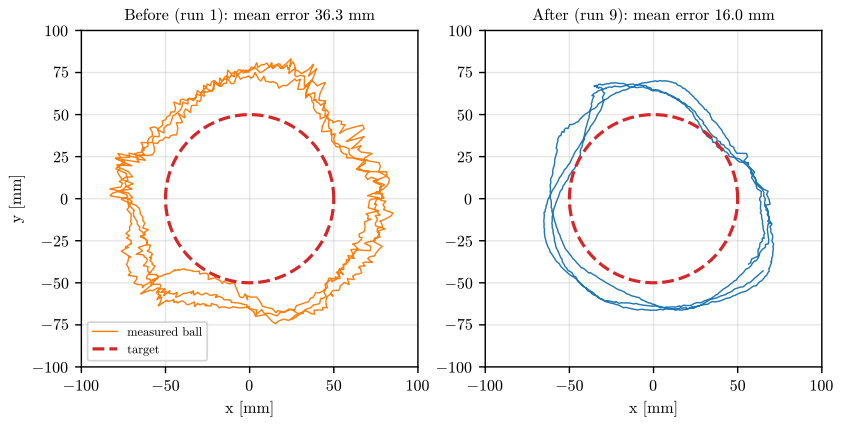
[picture p28: figure]
Before (run 1): mean error 36.3 mm; measured ball; target; After (run 9): mean error 16.0 mm

Figure 5.9: CIRCLE in steady state before (run 1) and after (run 9) the control changes.

The step tests of campaign B show the price of this change. A derivative term that no longer brakes a ball moving with the target also lets the ball run past a target that stops: on a 60 mm step the ball overshoots by about 60 % (Section 5.4). The same mechanism removes the lag on the curved patterns and makes their paths 9–31 % larger than the target. The step response of the original derivative term was not measured, so the difference cannot be quantified; since that term damps the ball’s own velocity, a smaller overshoot is expected, at the cost of the 0.4 s lag measured above.

## 5.8 Discussion and Limitations

The measurements show that the system holds the ball at a fixed point with an error of 2–3 mm and follows the three trajectories with an error of 12–17 mm, repeatable within about 1 mm over nine runs in two campaigns, which is small compared with the size of the trajectories (60 mm) and of the area in which the ball can move (about 117 mm from the center of the platform). It recovers from a light push within about 4 s and lost the ball only once in 43 min of testing. The remaining error is dominated by the outward deviation on curved paths rather than by lag, and the same property of the derivative term produces a large overshoot on target steps; the screw contacts are a consequence of the enlarged figure 8. Reducing these would probably require a feed-forward term derived from the target’s acceleration, or a model-based controller such as the LQR or MPC approaches proposed in the future developments; this was not tested.
The results have the following limitations:
- Number of runs: Three to four runs per pattern in campaign A and five in campaign B, each campaign recorded in one session and one lighting condition; the standard deviations describe the repeatability within these sessions only.
- Transitions: In campaign A each phase is preceded by a fixed pattern (the cycling order); in campaign B every test starts from the ball at rest, so the settling times characterize these transitions only.
- Derivative terms: Both derivative terms were compared on the patterns (campaign A); the step and disturbance tests were run with the final derivative term only.

- Taps by hand: The strength of the disturbances was not controlled.
- Single sensor: The ball position is measured by the same camera that closes the loop. Systematic errors of the vision system (for example in the depth scale) would affect the target and the measurement in the same way and are not visible in these metrics.

## 5.9 Bill of Materials and Project Cost

Table 5.9 lists the components of the system as described in this report, with the prices paid (including VAT). Spare parts, components bought for development but not used in the final system (magnetic encoders, an inertial measurement unit), the 3D-printed parts and small consumables (wiring, the plexiglass plate, the LED lighting and the master switch) are not included. The parts that make up the OctoBouncer cost 2,332.71 RON in total.

No. | Component | Supplier | Qty | Unit [RON] | Total [RON]
1 | Raspberry Pi 5, 8 GB | – | 1 | 415.00 | 415.00
2 | Raspberry Pi Global Shutter Camera | – | 1 | 218.00 | 218.00
3 | Fisheye camera lens | TME | 1 | 108.93 | 108.93
4 | Teensy 4.1 | Optimus Digital | 1 | 200.00 | 200.00
5 | Shield for the Raspberry Pi 5 | Optimus Digital | 1 | 28.37 | 28.37
6 | DM556 stepper driver | Optimus Digital | 4 | 59.99 | 239.96
7 | NEMA 17 stepper motor, 1.5 A | Robofun | 4 | 94.35 | 377.40
8 | AC-DC power supply 48V, 500W | – | 1 | 413.47 | 413.47
9 | Step-down converter EMG122 | eMAG | 2 | 61.99 | 123.98
10 | Metal motor bracket | TME | 4 | 27.00 | 108.00
11 | Precision bearing | Optimus Digital | 16 | 2.49 | 39.84
12 | Screw M3 × 70 mm | Optimus Digital | 24 | 2.49 | 59.76
Total | | | | | 2,332.71

Table 5.9: Bill of materials of the components used in the system (prices including VAT).

## 5.10 Industrial and Commercial Applications

The technology developed in OctoBouncer is not limited to balancing a ball. Its core is the combination of three elements that are generally useful in automation: contactfree measurement of an object’s position on a surface with a single calibrated camera, real-time control of the tilt and height of a platform driven by a parallel mechanism, and trajectory tracking with a closed feedback loop. The measurements in Section 5.3 show what this combination achieves on low-cost hardware: an object held at a fixed point within a few millimeters, and predefined paths followed with a repeatable error of

12–17 mm, with vision at 60 Hz and control at 200 Hz. These capabilities can be applied directly in the following real-world fields:

- Stabilized transport platforms: Service robots, automated guided vehicles (AGVs) and delivery systems that carry liquids or fragile goods need a platform that tilts against the accelerations of the vehicle, so that the load does not slide or spill. The inverse kinematics and the height control of OctoBouncer solve exactly this problem; the camera would be complemented by an inertial sensor measuring the motion of the base.
- Motion simulators and test benches: Platforms with controlled pitch, roll and height are the basis of driving and flight simulators and of test benches that expose products or sensors (for example inertial measurement units) to defined movements. The four-arm parallel mechanism offers these three degrees of freedom with simpler mechanics than a six-actuator Stewart platform [14], and the trajectory generator can reproduce defined test movements.
- Material handling without grippers: In manufacturing, small parts can be positioned, aligned or sorted by tilting the surface they lie on, instead of being picked up. The vision-guided control of OctoBouncer moves a free object along a prescribed path in exactly this way, which applies to part feeders, sorting tables and the alignment of components before assembly.
- Leveling and orientation systems: Work tables, optical benches, antennas and solar panels have to be kept level or oriented in a defined direction. The same control structure (measurement, PID controller, inverse kinematics) keeps a platform at a set orientation and height, with the camera replaced by the sensor relevant for the application.
- Medical rehabilitation and balance training: Tilting platforms are used in physiotherapy for ankle rehabilitation and balance training. Programmable trajectories such as CIRCLE or FIGURE 8 correspond to the controlled movement patterns used in these exercises, and the height control makes it possible to adapt the platform to the patient.
- Education and research: Ball-and-plate systems are established laboratory equipment in control engineering education [1]. OctoBouncer can be used as a teaching platform covering image processing, inverse kinematics, PID tuning and real-time embedded programming on open hardware, for about 2,333 RON in components (Section 5.9).

In all these applications the system would keep its architecture: a high-level processor for perception, a real-time microcontroller for control, and a parallel mechanism for actuation. The main adaptations would be the sensor (camera, inertial sensor or distance sensor, depending on the task), the size and load capacity of the mechanism, and the safety certification required in an industrial or medical environment.

## 5.11 Conclusions and Future Developments

The OctoBouncer project successfully demonstrated the convergence between mechatronics and automatic control. Although the current PET-G prototype is perfectly functional for stabilization tasks (Ball and Plate), the rigidity of the plastic limits the frequency of violent movements.
For the future, we propose the following development directions:
1. Change of Material: CNC machining of the arms from aluminum to maximize rigidity and to activate the full “bouncing” function (the rhythmic throwing and catching of the ball).
2. Complex Trajectories: Implementing trajectory generators through direct input from the user.
3. Advanced Control: Exploring LQR (Linear-Quadratic Regulator) or Model Predictive Control (MPC) algorithms to replace the classic PID.

# Bibliography

[1] W. Yu, F. Ortiz, “Optimized Fuzzy Control of a Ball and Plate System,” Proceedings of the IEEE International Symposium on Intelligent Control, pp. 7–12, 2004.
[2] Electron Dust, The Octo-Bouncer https://www.electrondust.com/2020/03/01/the-octo-bouncer/ (https://www.electrondust.com/2020/03/01/the-octo-bouncer/)
[3] Raspberry Pi Foundation, Raspberry Pi 5 Product Brief, Raspberry Pi Foundation, 2023. https://pip-assets.raspberrypi.com/categories/892-raspberry-pi-5/documents/RP-008348-DS-6-raspberry-pi-5-product-brief.pdf (https://pip-assets.raspberrypi.com/categories/892-raspberry-pi-5/documents/RP-008348-DS-6-raspberry-pi-5-product-brief.pdf)
[4] PJRC, Teensy 4.1 Technical Specifications, PJRC Electronics, 2020. https://www.pjrc.com/store/teensy41.html
[5] Leadshine Technology, DM556 Digital Stepper Drive User Manual, Leadshine Technology Co., Ltd., 2015. https://www.leadshine.com
[6] Robofun, NEMA 17 Stepper Motor, 1.5 A, 200 Steps, with Cable, https://www.robofun.ro/motor-stepper-nema17-1-5a-200-pasi-cu-cablu.html
[7] G. Bradski, A. Kaehler, Learning OpenCV: Computer Vision with the OpenCV Library, O’Reilly Media, 2008.
[8] J. Kannala, S. S. Brandt, “A Generic Camera Model and Calibration Method for Conventional, Wide-Angle, and Fish-Eye Lenses,” IEEE Transactions on Pattern Analysis and Machine Intelligence, vol. 28, no. 6, pp. 1335–1340, Jun. 2006.
[9] OpenCV Development Team, OpenCV 4.x Documentation: Camera Calibration and 3D Reconstruction, 2024. https://docs.opencv.org/4.x/d9/d0c/group__calib3d. html (https://docs.opencv.org/4.x/d9/d0c/group__calib3d.html)
[10] R. C. Gonzalez, R. E. Woods, Digital Image Processing, 4th ed., Pearson, 2018.
[11] K. J. ˚Astr¨om, T. H¨agglund, PID Controllers: Theory, Design and Tuning, 2nd ed., Instrument Society of America, 1995.
[12] K. J. ˚Astr¨om, B. Wittenmark, Computer-Controlled Systems: Theory and Design, 3rd ed., Prentice Hall, 1997.
[13] J. P. Merlet, Parallel Robots, 2nd ed., Springer, 2006.
[14] D. Stewart, “A Platform with Six Degrees of Freedom,” Proceedings of the Institution of Mechanical Engineers, vol. 180, no. 1, pp. 371–386, 1965.
[15] M. Galeja et al., “Mechanical Properties of 3D-Printed PETG Polymer,” Polymers, vol. 12, no. 12, art. 2959, 2020.

[16] Ontario Tech University, Camera Calibration in OpenCV https://csundergrad.science.uoit.ca/courses/cv-notes/notebooks/02-camera-calibration.html (https://csundergrad.science.uoit.ca/courses/cv-notes/notebooks/02-camera-calibration.html)
[17] Raspberry Pi Foundation, Picamera2 Library Documentation, 2023. https://datasheets.raspberrypi.com/camera/picamera2-manual.pdf
[18] PlatformIO Labs, PlatformIO IDE and Build System Documentation. https://docs. platformio.org (https://docs.platformio.org)
[19] G. | Hunter, | Exponential Moving Average (EMA) Filter, | 2024. | https:
//blog.mbedded.ninja/programming/signal-processing/digital-filters/ exponential-moving-average-ema-filter/ (https://blog.mbedded.ninja/programming/signal-processing/digital-filters/exponential-moving-average-ema-filter/)
