alexivan04/Pong-Stabilizer/images_for_doc/circle_mode.png

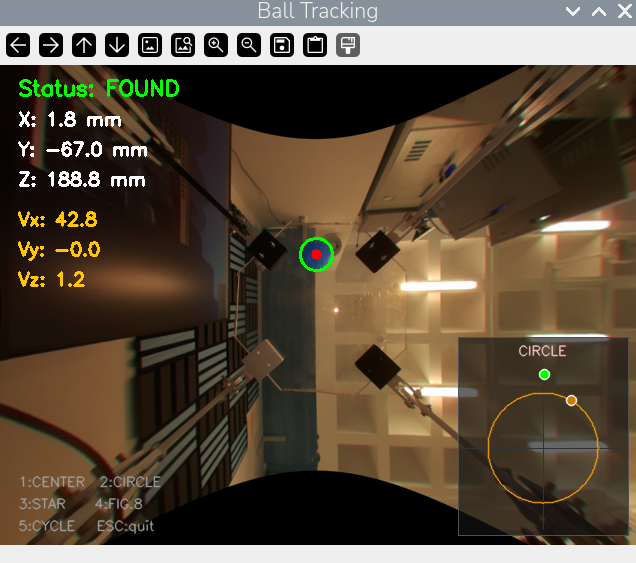
images_for_doc/circle_mode.png
