alexivan04/Pong-Stabilizer/images_for_doc/color_calib.png

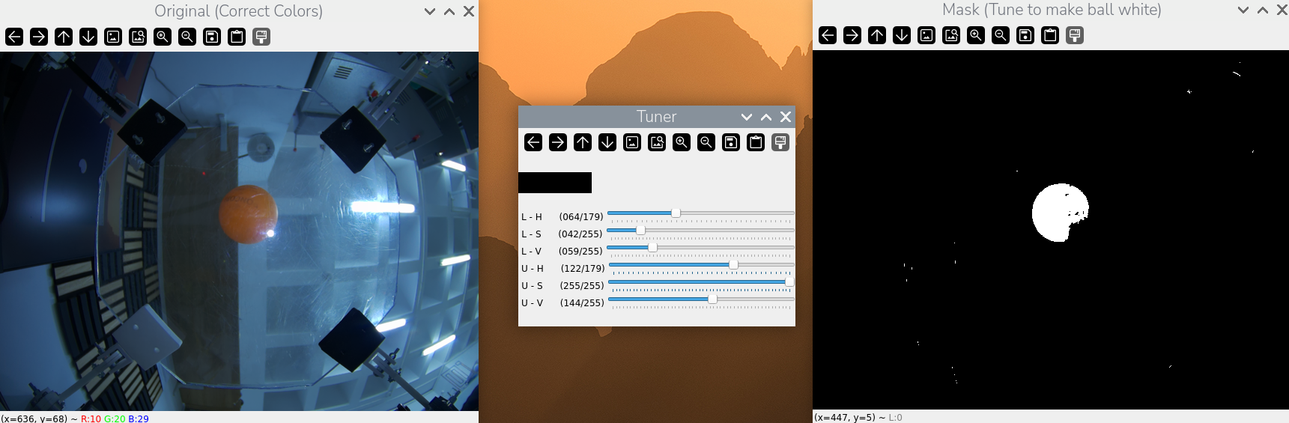
images_for_doc/color_calib.png
