alexivan04/Pong-Stabilizer/images_for_doc/figure_eight_mode.png

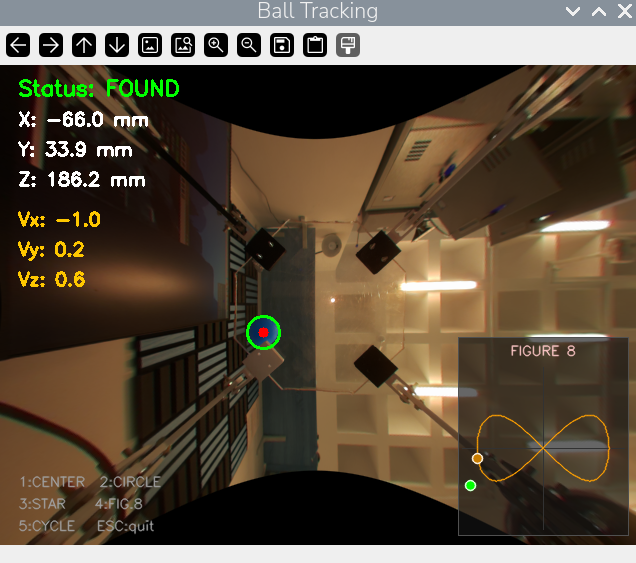
images_for_doc/figure_eight_mode.png
