alexivan04/Pong-Stabilizer/images_for_doc/TOATE/cad_render.png

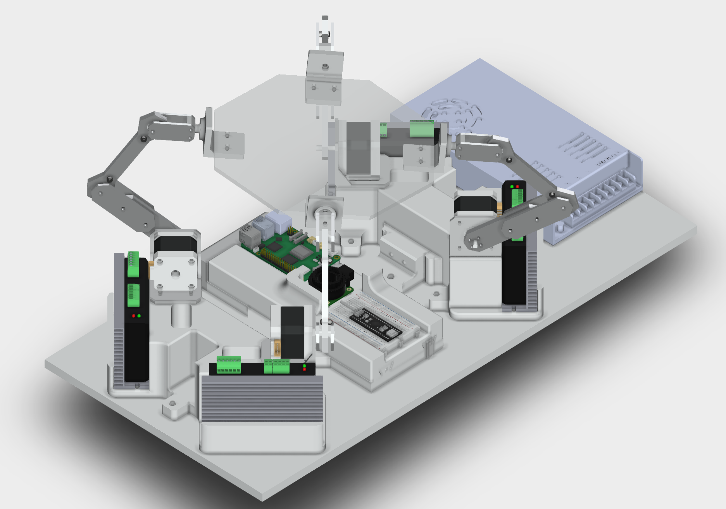
images_for_doc/TOATE/cad_render.png
