alexivan04/Pong-Stabilizer/screenshot2.png

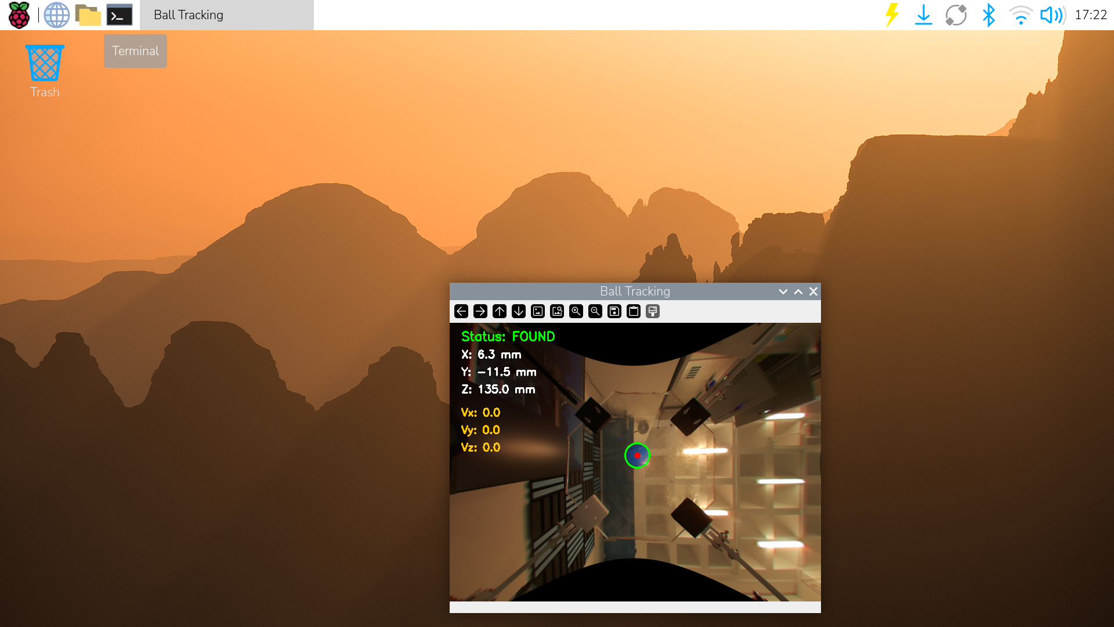
screenshot2.png
