alexivan04/Pong-Stabilizer/screenshot.png

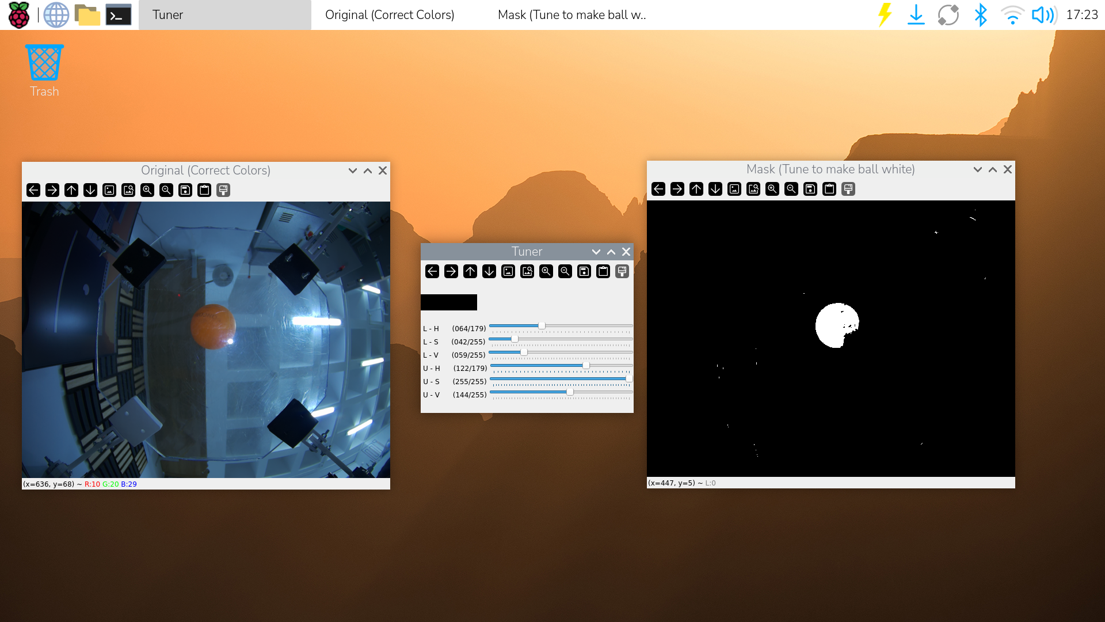
screenshot.png
