alexivan04/Pong-Stabilizer/docs/report/tests/figures/test_patterns.png

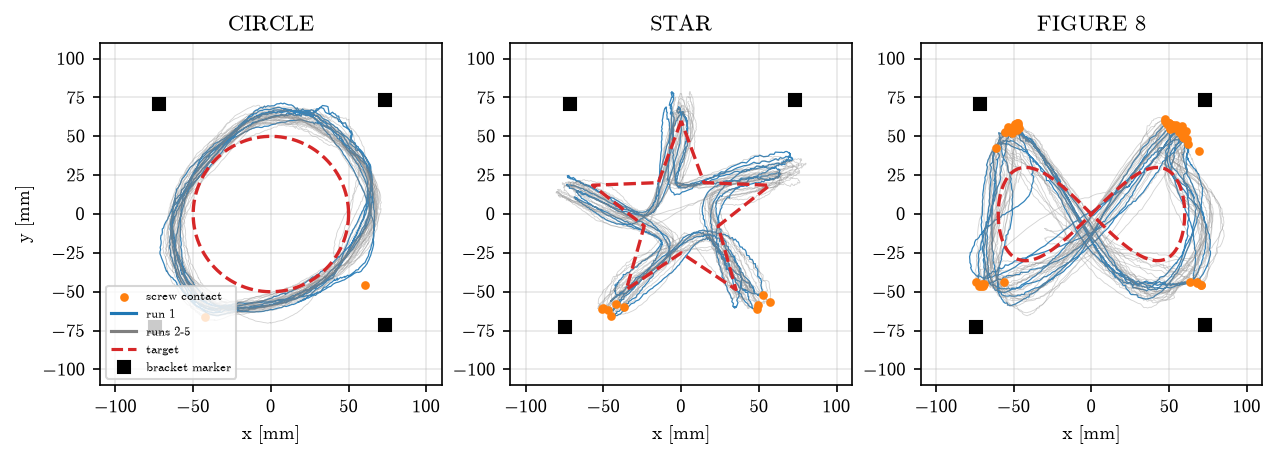
docs/report/tests/figures/test_patterns.png
