alexivan04/Pong-Stabilizer/pi_code/camera_calib/calibration_images/img_14.jpg

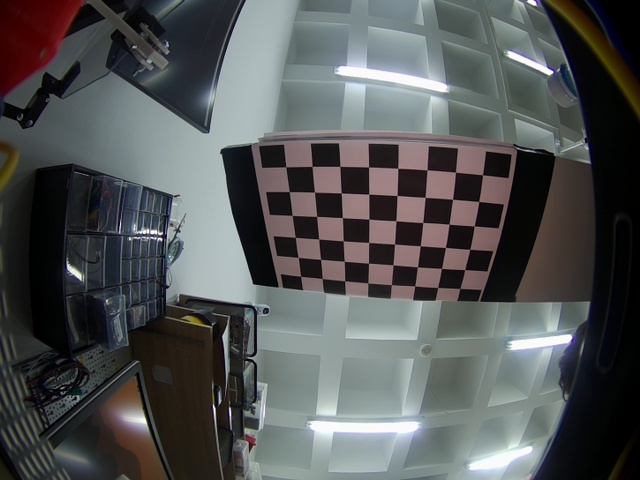
pi_code/camera_calib/calibration_images/img_14.jpg
