alexivan04/Pong-Stabilizer/hardware/schematic/octobouncer_schematic.pdf

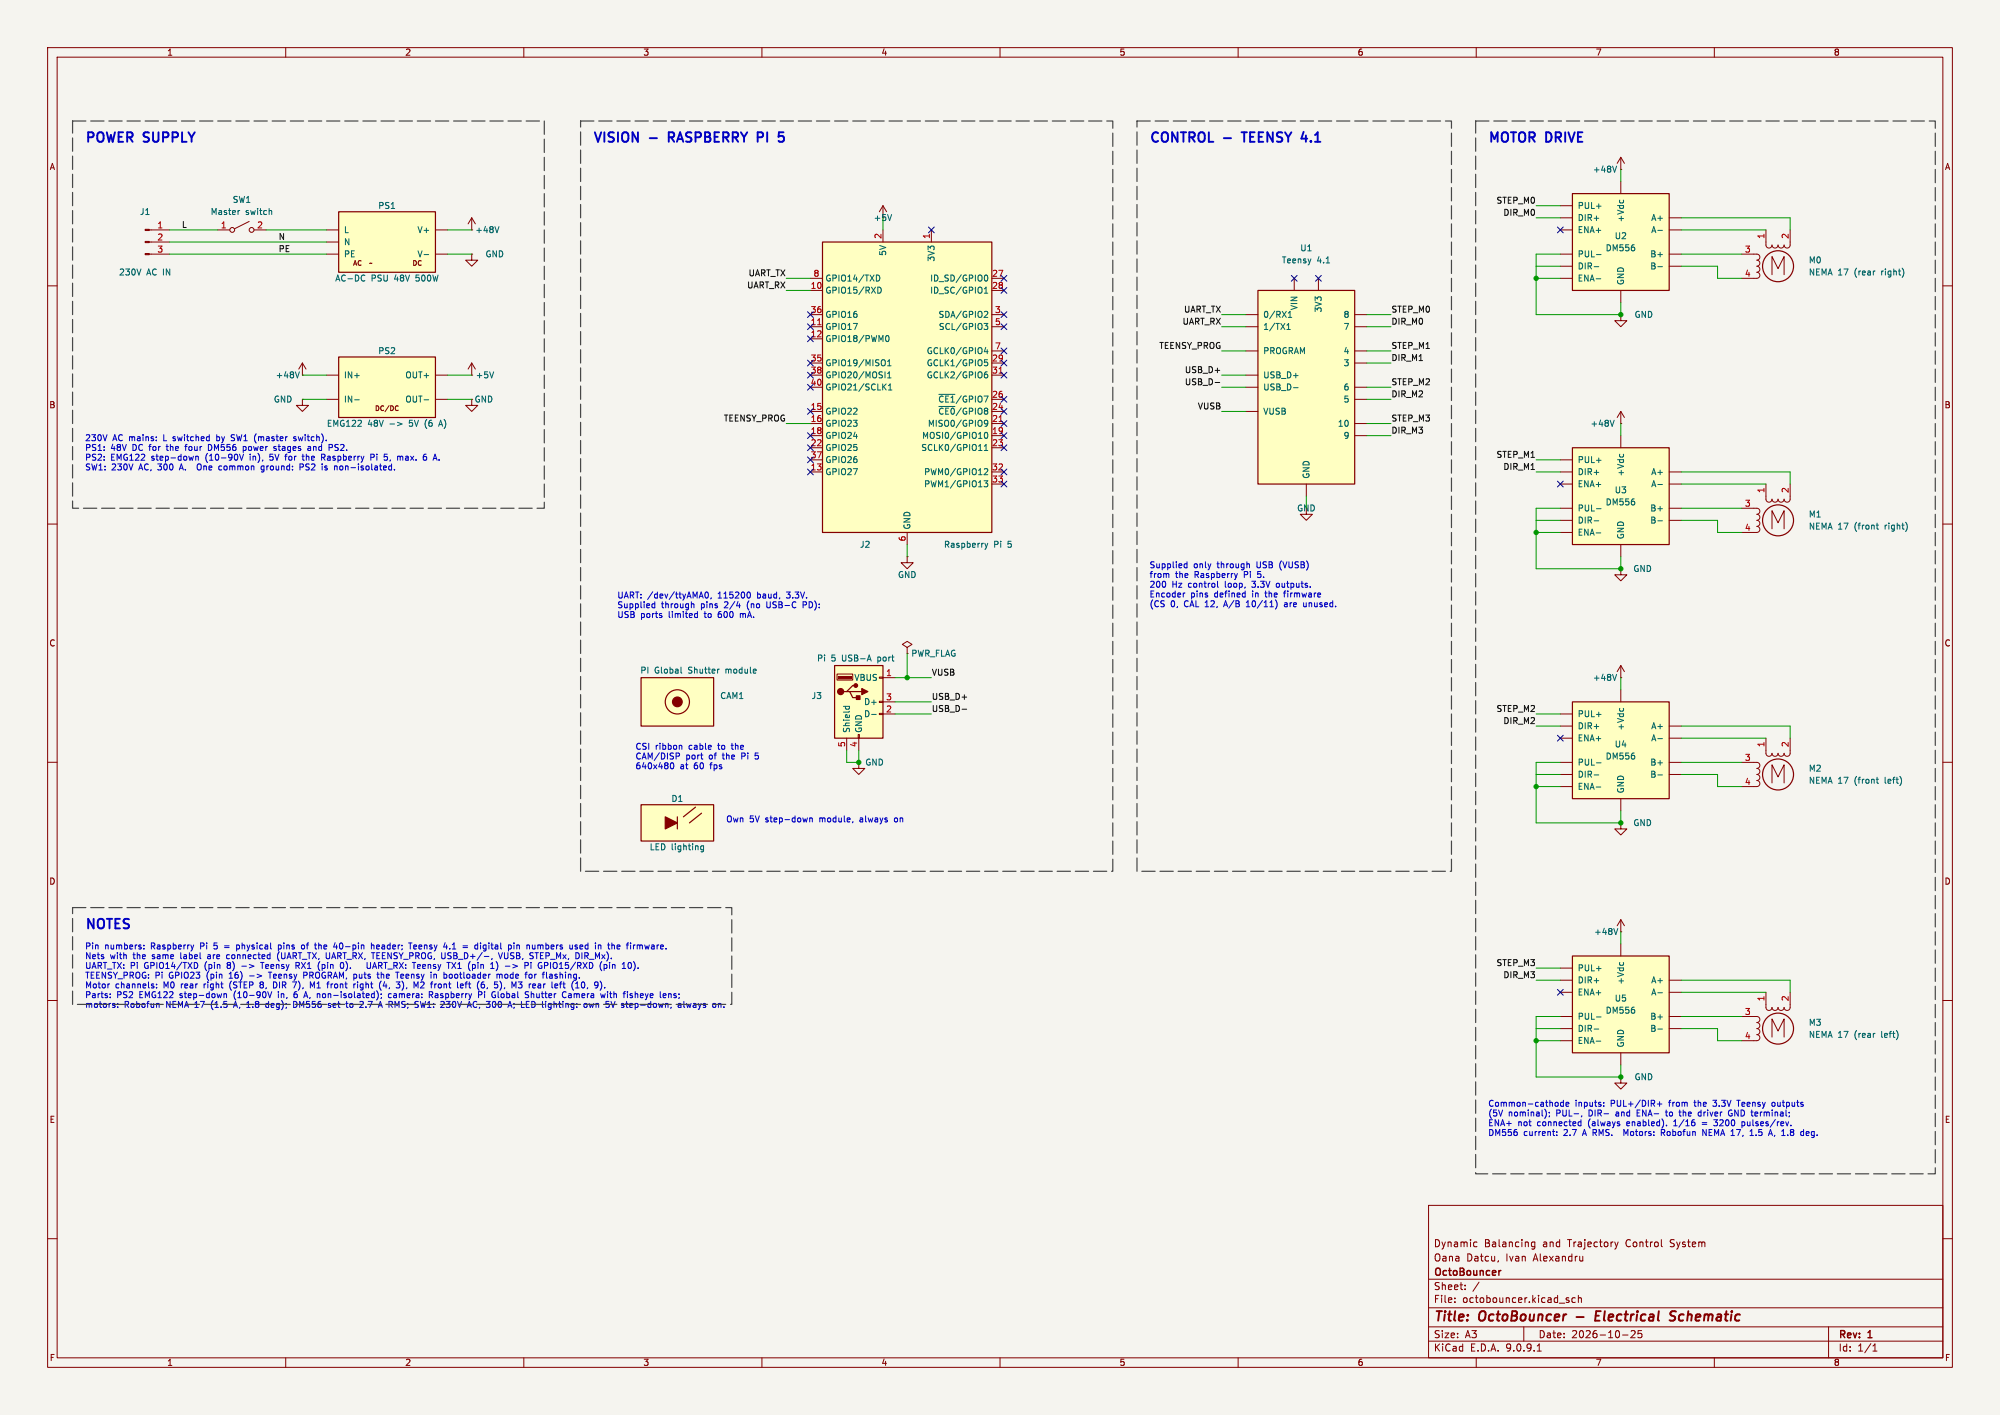
[picture p53: page 1]

Supplied only through USB (VUSB)

J3Pi 5 USB-A port CAM1 PI Global Shutter module

2 M2 NEMA 17 (front left) GND

Id: 1/1 Title: OctoBouncer - Electrical Schematic
