alexivan04/Pong-Stabilizer/docs/report/figures/test_contacts.pdf

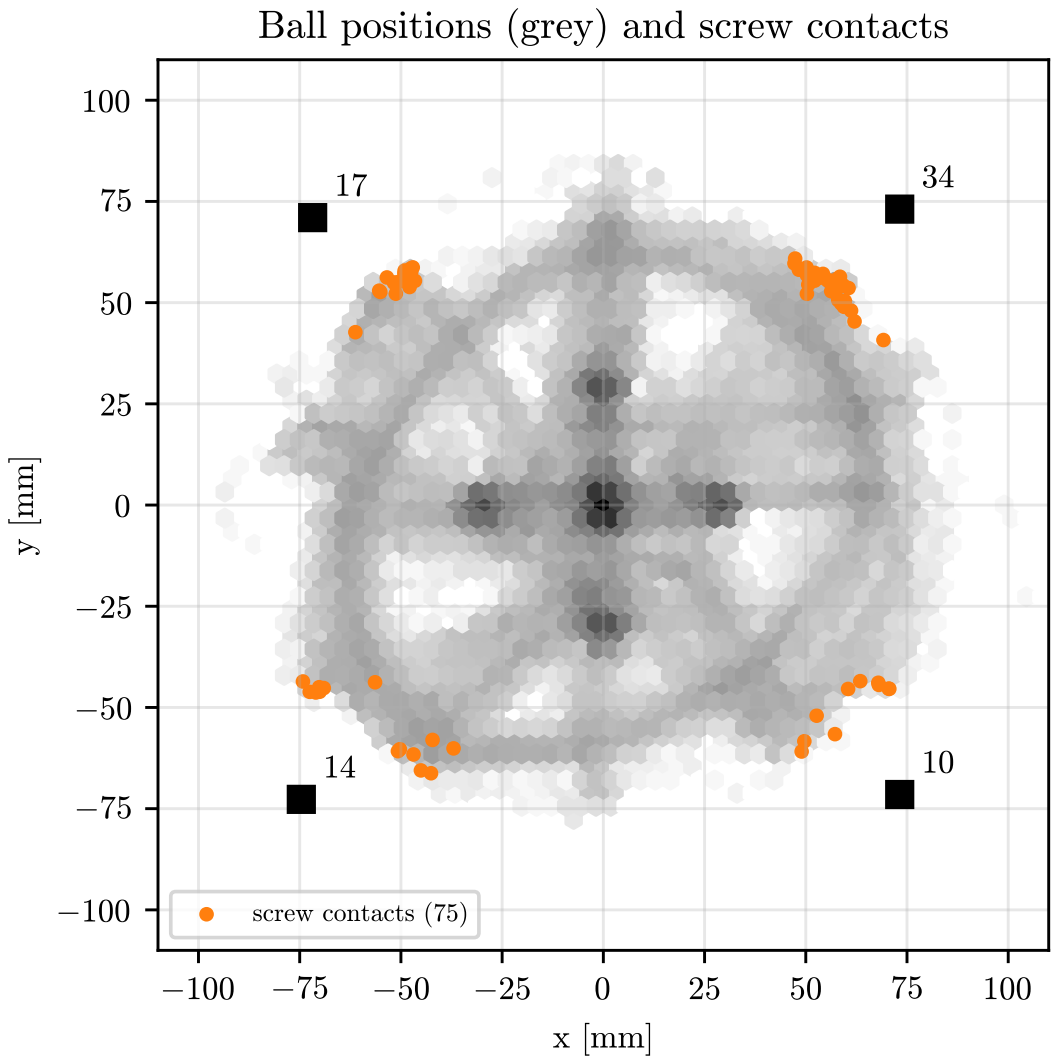
[picture p54: page 1]
screw contacts (75)

Ball positions (grey) and screw contacts
