alexivan04/Pong-Stabilizer/docs/report/figures/test_patterns.pdf

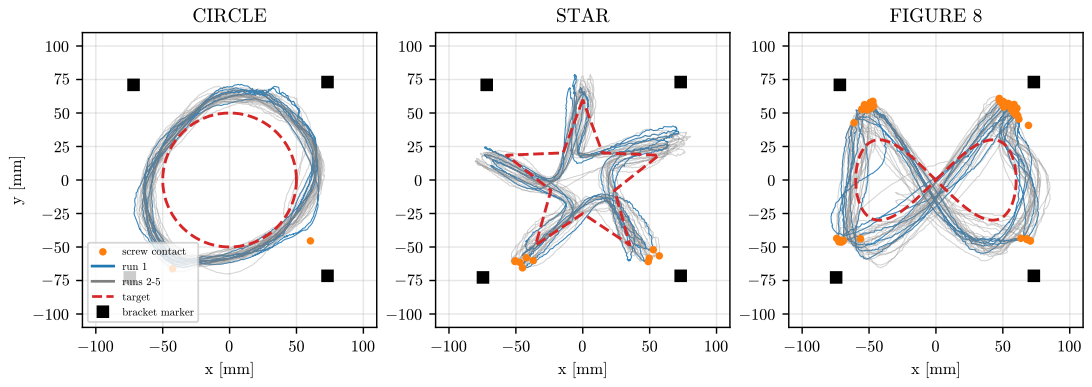
[picture p55: page 1]
CIRCLE; STAR; FIGURE 8

screw contact run 1

runs 2-5 target bracket marker
