alexivan04/Pong-Stabilizer/docs/report/figures/test_steps.pdf

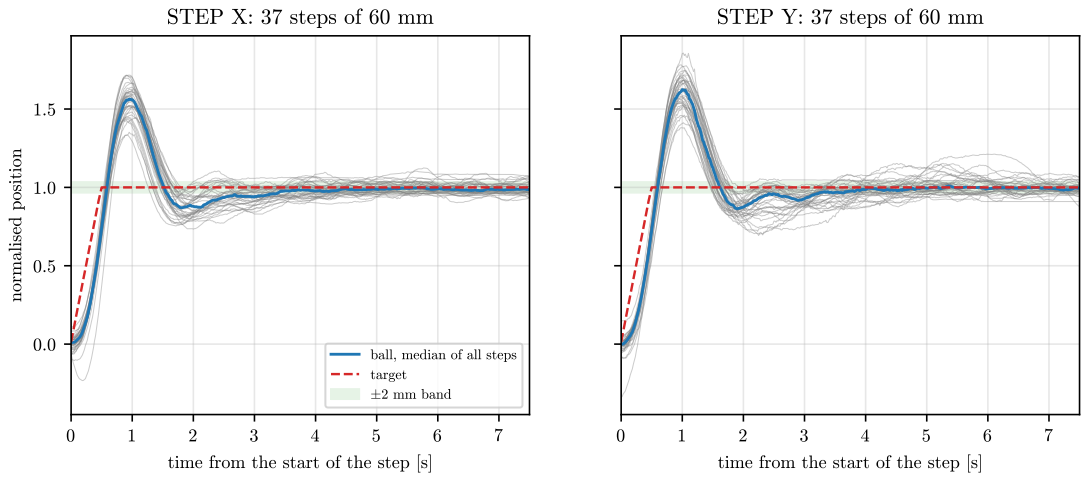
[picture p56: page 1]
normalised position

STEP X: 37 steps of 60 mm

STEP Y: 37 steps of 60 mm

ball, median of all steps
target
§2 mm band

time from the start of the step [s]
