alexivan04/Pong-Stabilizer/docs/report/tests/figures/test_contacts.pdf

screw contacts (75)

Ball positions (grey) and screw contacts
