alexivan04/Pong-Stabilizer/docs/report/tests/figures/test_disturb.pdf

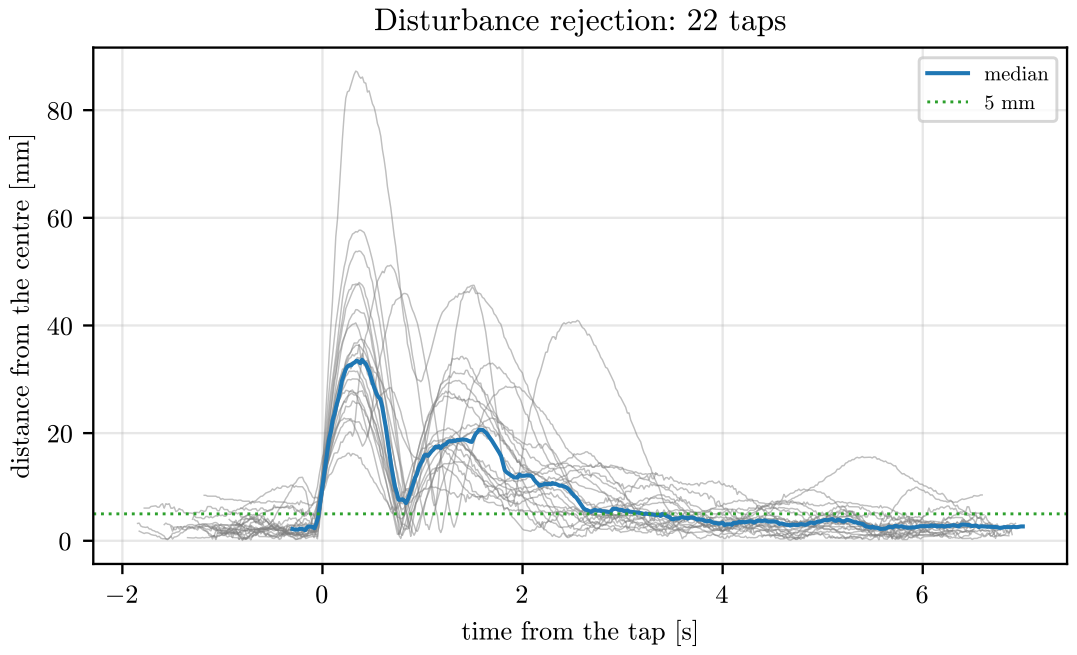
[picture p57: page 1]
median 5 mm

Disturbance rejection: 22 taps

distance from the centre [mm]

time from the tap [s]
