alexivan04/Pong-Stabilizer/docs/report/tests/figures/test_patterns.pdf

CIRCLE; STAR; FIGURE 8

screw contact run 1

runs 2-5 target bracket marker
