alexivan04/Pong-Stabilizer/docs/report/figures/trajectories_xy.pdf

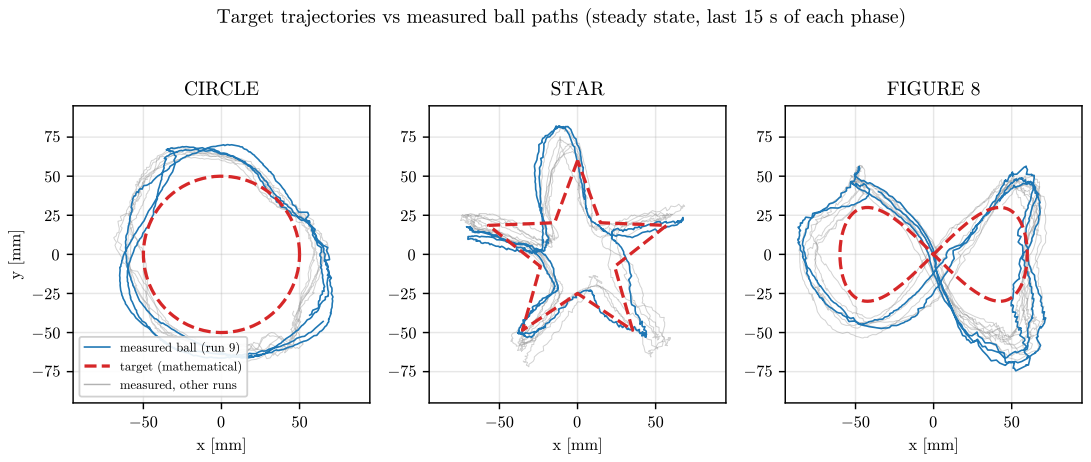
[picture p58: page 1]
CIRCLE; STAR; FIGURE 8

Target trajectories vs measured ball paths (steady state, last 15 s of each phase)

measured ball (run 9) target (mathematical)

measured, other runs
