alexivan04/Pong-Stabilizer/hardware/schematic/octobouncer.kicad_sch

## KiCad design hardware/schematic/octobouncer.kicad_sch (2026-10-25)

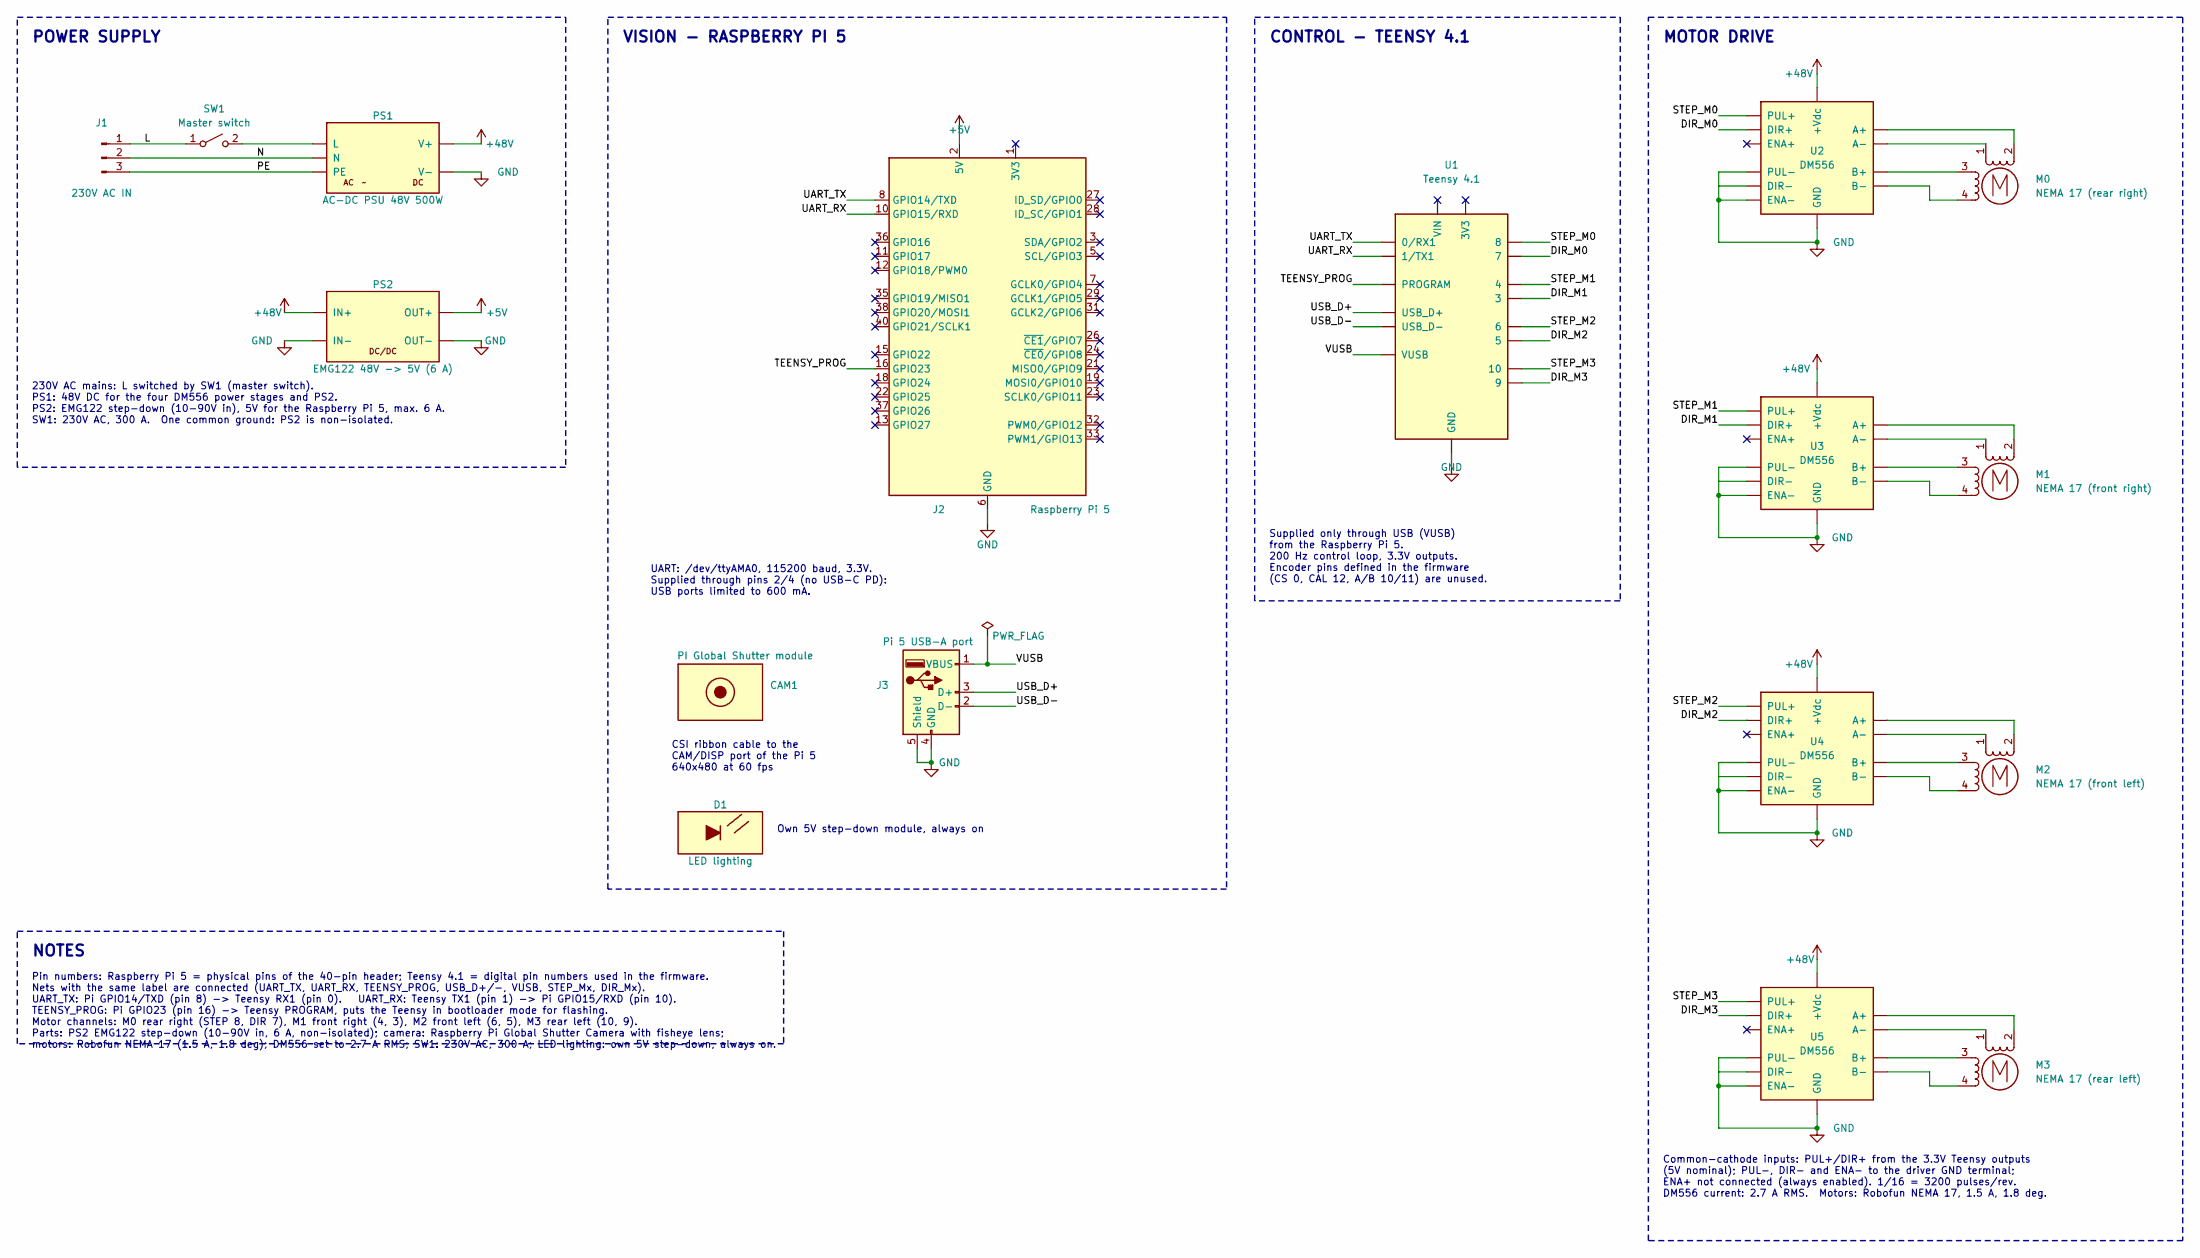
[picture p59: schematic octobouncer.kicad_sch]

Parts:
CAM1: PI Global Shutter module
D1: LED lighting
J1: 230V AC IN
J2: Raspberry Pi 5
J3: Pi 5 USB-A port
M0: NEMA 17 (rear right)
M1: NEMA 17 (front right)
M2: NEMA 17 (front left)
M3: NEMA 17 (rear left)
PS1: AC-DC PSU 48V 500W
PS2: EMG122 48V -> 5V (6 A)
SW1: Master switch
U1: Teensy 4.1
U2, U3, U4, U5: DM556

Connections:
+5V: J2.2 (5V), J2.4 (5V), PS2.OUT+
+48V: PS1.V+, PS2.IN+, U2.+V (+Vdc), U3.+V (+Vdc), U4.+V (+Vdc), U5.+V (+Vdc)
DIR_M0: U1.7, U2.DIR+
DIR_M1: U1.3, U3.DIR+
DIR_M2: U1.5, U4.DIR+
DIR_M3: U1.9, U5.DIR+
GND: J2.6 (GND), J2.9 (GND), J2.14 (GND), J2.20 (GND), J2.25 (GND), J2.30 (GND), J2.34 (GND), J2.39 (GND), J3.4 (GND), J3.5 (Shield), PS1.V-, PS2.IN-, PS2.OUT-, U1.GND, U2.DIR-, U2.ENA-, U2.GND, U2.PUL-, U3.DIR-, U3.ENA-, U3.GND, U3.PUL-, U4.DIR-, U4.ENA-, U4.GND, U4.PUL-, U5.DIR-, U5.ENA-, U5.GND, U5.PUL-
L: J1.1, SW1.1 (A)
N: J1.2, PS1.N
unnamed: J2.1 (3V3), J2.17 (3V3)
unnamed: M0.1, U2.A-
unnamed: M0.2 (-), U2.A+
unnamed: M0.3, U2.B+
unnamed: M0.4, U2.B-
unnamed: M1.1, U3.A-
unnamed: M1.2 (-), U3.A+
unnamed: M1.3, U3.B+
unnamed: M1.4, U3.B-
unnamed: M2.1, U4.A-
unnamed: M2.2 (-), U4.A+
unnamed: M2.3, U4.B+
unnamed: M2.4, U4.B-
unnamed: M3.1, U5.A-
unnamed: M3.2 (-), U5.A+
unnamed: M3.3, U5.B+
unnamed: M3.4, U5.B-
unnamed: PS1.L, SW1.2 (B)
PE: J1.3, PS1.PE
STEP_M0: U1.8, U2.PUL+
STEP_M1: U1.4, U3.PUL+
STEP_M2: U1.6, U4.PUL+
STEP_M3: U1.10, U5.PUL+
TEENSY_PROG: J2.16 (GPIO23), U1.PROG (PROGRAM)
UART_RX: J2.10 (GPIO15/RXD), U1.1 (1/TX1)
UART_TX: J2.8 (GPIO14/TXD), U1.0 (0/RX1)
USB_D+: J3.3 (D+), U1.D+ (USB_D+)
USB_D-: J3.2 (D-), U1.D- (USB_D-)
VUSB: J3.1 (VBUS), U1.VUSB

Notes on the sheet:
CONTROL - TEENSY 4.1
Own 5V step-down module, always on
Supplied only through USB (VUSB) from the Raspberry Pi 5. 200 Hz control loop, 3.3V outputs. Encoder pins defined in the firmware (CS 0, CAL 12, A/B 10/11) are unused.
MOTOR DRIVE
230V AC mains: L switched by SW1 (master switch). PS1: 48V DC for the four DM556 power stages and PS2. PS2: EMG122 step-down (10-90V in), 5V for the Raspberry Pi 5, max. 6 A. SW1: 230V AC, 300 A. One common ground: PS2 is non-isolated.
Pin numbers: Raspberry Pi 5 = physical pins of the 40-pin header; Teensy 4.1 = digital pin numbers used in the firmware. Nets with the same label are connected (UART_TX, UART_RX, TEENSY_PROG, USB_D+/-, VUSB, STEP_Mx, DIR_Mx). UART_TX: Pi GPIO14/TXD (pin 8) -> Teensy RX1 (pin 0). UART_RX: Teensy TX1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
UART: /dev/ttyAMA0, 115200 baud, 3.3V. Supplied through pins 2/4 (no USB-C PD): USB ports limited to 600 mA.
Common-cathode inputs: PUL+/DIR+ from the 3.3V Teensy outputs (5V nominal); PUL-, DIR- and ENA- to the driver GND terminal; ENA+ not connected (always enabled). 1/16 = 3200 pulses/rev. DM556 current: 2.7 A RMS. Motors: Robofun NEMA 17, 1.5 A, 1.8 deg.
POWER SUPPLY
CSI ribbon cable to the CAM/DISP port of the Pi 5 640x480 at 60 fps
NOTES
VISION - RASPBERRY PI 5
