alexivan04/Pong-Stabilizer/(commit log)

2026-01-23 added a wrapper for controlling steppers with pulses from timers
2026-01-23 added support for 4 steppers
2026-02-21 added UART communication on teensy and restructured
2026-02-21 added UART communication and enhanced ball tracking
2026-03-06 added timers, acceleration control for steppers and a filter for the PID
2026-03-10 refined movements and calibrated pid
2026-03-10 added pid calibration gui
2026-03-10 more PID tuning
2026-03-17 improved camera tracking and packets
2026-03-17 added start command for teensy
2026-03-17 adapted D term to velocity and calibrated modes
2026-03-22 include velocity
2026-10-24 Pi: calibration-free ball detection, smoothed Z, safe exit
    Replace the per-script HSV detection with a shared module, ball_detector.py,
    used by 4_gui_track_w_mode.py, 4_gui_track_pid.py and 4_headless_track.py.
    Detection (DETECTOR_MODE):
    - "auto" (default): no colour calibration. The ball is the round, ball-sized
    blob on the plate whose outline stays stable while a saturation threshold
    is lowered (maximally stable region, as in MSER), so brightness, colour
    temperature and backlight haze need no re-tuning. Convex-hull roundness
    survives glare cutting into the ball's edge; a minimum inner saturation
    rejects a dull brown patch seen through the plate corner. ~2 ms per frame
    while tr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
2026-10-24 Teensy: real START wait, safe arm range, height control, D term vs target
    Bug fix:
    - main() waited with `while (!isStarted);` on a non-volatile flag without
    reading serial, so the compiler removed the loop (confirmed in the
    disassembly) and the arms moved the moment the Teensy booted or was
    flashed. Now volatile and `while (!isStarted) checkSerial();`.
    Units:
    - UNIT_SCALE (1.4): the Pi now sends real mm, ~1.4x the old units. Kp, Ki,
    Kd are divided by it (0.106/0.080/0.049); the plate limit and integral
    limit are multiplied, so the response matches the tuning.
    - PATTERN_SCALE (1.0): pattern size and target speed, separate on purpose;
    at 1.4 the star and figure-8 reached 84 mm and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
2026-10-24 flash_teensy.sh: new Pi address, fail early on missing file or SSH
    Committed as edited by hand on the rig:
    - PI_IP 10.41.234.223 -> 172.20.10.3
    - set -euo pipefail
    - check the firmware file exists and SSH answers before copying
    Known issue: with `set -u`, running it without an argument stops at "$1:
    unbound variable" instead of printing the usage line. The GPIO 23 bootloader
    pulse in ~/main.py also stopped working; flash with teensy_loader_cli -s
    (see docs/ball-tracking-and-control.md).
2026-10-24 docs: ball tracking and plate control
    How the calibration-free detection, units/scaling, D term, START wait, arm
    range and height loop work; how to start, stop, flash and log the rig; the
    serial protocol; tuning knobs; measured results; known issues (Pi
    undervoltage resets, GPIO flash pulse, checkSerial() buffer overflow, old
    scripts still in old units).
2026-10-24 Add project README
    Overview and architecture diagram, hardware, repository layout, setup (Pi
    packages, PlatformIO, flashing), how to run and stop the rig, camera and plate
    calibration, how ball detection and control work, serial protocol, tuning
    constants, logging, troubleshooting and known issues. Links to
    docs/ball-tracking-and-control.md for the details.
2026-10-25 Report: experimental results, consistency fixes against the code
    - docs/report/main_english.tex: full English report with the new
    Chapter 5 (trajectory tracking, settling time, steady-state error,
    before/after comparison, limitations, applications), the electrical
    pin table and component ratings, and the text corrected to match the
    firmware (linear arm mixing, D term on the velocity relative to the
    target, plate height control, depth median filter)
    - docs/report/analyze_runs.py: regenerates every figure and table from
    the logged runs in docs/report/data/
    - figures/: plots and the schematic export used by the report
2026-10-25 Add KiCad schematic of the electronics
    KiCad 9 project with a project symbol library (Teensy 4.1, DM556,
    AC-DC supply, EMG122 step-down, camera, LED lighting). ERC clean; nets
    match the pin table in the report.
2026-10-25 Plate-centred positions, edge guard, test protocol
    - ball_detector.py: ball positions relative to the plate centre (8.0, -1.2 mm
    from the optical centre, measured with markers on the level plate), so
    CENTER and the patterns sit in the middle of the plate
    - firmware: edge guard (target back to the centre while the ball is beyond
    85 mm, resumes inside 40 mm) and the test-only STEP_X/STEP_Y patterns (5, 6)
    - 5_test_runner.py: automated test protocol (centre hold, step responses,
    patterns from rest, taps), logs every frame with its phase
2026-10-25 Analysis of the automated test protocol (25 Oct, 5 runs, 43 min)
    analyze_tests.py regenerates metrics.json, the tables and figures from
    data/test_20261025_154451.csv.gz: CENTER hold, 74 step responses,
    patterns from rest with exposure-time lag, 22 detected taps, screw
    contacts (velocity jumps near the brackets) and the one ball loss.
2026-10-25 Report: campaign B (automated test protocol) in Chapter 5
    Two test campaigns: A (24 Oct, cycling mode, both derivative terms) and
    B (25 Oct, automated protocol, 5 runs, final derivative term). New
    sections on the step response, disturbance rejection, screw contacts and
    ball losses; campaign B added to the trajectory and CENTER results; the
    overshoot on steps as the measured cost of the relative-velocity D term;
    Chapters 3 and 4 updated to the current limits (17-30 deg, tilt -12 deg),
    plate-centred coordinates, the edge guard and the test patterns.
2026-10-25 Teensy: more tilt room below (minimum height 17 deg, tilt limit -12 deg)
    With 10 deg below the working height, the low-side arm hit its 5 deg
    limit as soon as pitch and roll together asked for more than 10 deg and
    stopped reacting. The GUI's plate-height display range follows.
2026-10-25 Report: bill of materials (components used in the system, 2,332.71 RON)
2026-10-25 Teensy: no upper plate-height cap below the arm limit
    The height control was capped 10 deg below the 40 deg arm limit and
    stopped there while the plate still had to rise; it now goes up to the
    arm limit, which still clamps every arm. Report and GUI display updated.
2026-10-25 Report: figure 8 settling shown as -- (no transient) instead of 0
    The STAR to FIGURE 8 switch never left the settling band, so the formula
    gave 0 s; the tables now show -- and the captions say what it means.
2026-10-25 Pi: reject implausible ball detections
    A detection farther from the last accepted one than the ball can travel
    (1500 mm/s + 15 mm) is reported as lost until 5 frames in a row agree on
    the new place; the same holds for the first detections after a loss. False
    blobs made the arms move chaotically.
2026-10-25 Teensy: re-home after a lost ball, integral freeze, lower step speed
    Without encoders, violent moves lost steps: the counted height drifted up
    (34 deg counted, Z said ~8 deg) and a tilt offset held the ball 65 mm off
    centre. After 3 s without a ball the arms now sink slowly 4 deg below the
    counted stop, stall on the real one and are zeroed there again.
    The integral is frozen while the ball is lost and emptied over 1 s after a
    longer loss. Max step rate 35000 -> 10000 steps/s.
    Also a start-up tune (motors play a short melody as a small wobble),
    switched off with STARTUP_TUNE = false.
2026-10-25 TODO: markers stay dots, screen power budget
2026-10-25 TODO: MGL17-G5 gearbox, bouncing estimate, faster camera, hardware trigger
2026-10-25 TODO: sources for the camera crop and the external trigger
2026-10-25 README: current state (plate-centred coordinates, plausibility check, re-homing, limits, test protocol, hardware)
2026-10-26 Report: maximum vertical acceleration (motor torque, not PET-G, limits the bounce)
    Direct drive: ~0.85 g usable upward acceleration, below the ~1 g a 1 cm
    bounce needs over a 10 mm stroke; a 5:1 gearbox gives ~7 g. The arm load is
    bounded by the motor torque, so the PET-G arms need only a ~3x6 mm (direct)
    or ~5x10 mm (gearbox) section at 20 MPa allowable stress.
2026-10-26 Report: arm stress from the CAD (two 3x25 mm plates, safety factor 17 direct / 3.8 with 5:1)
2026-10-26 Report: arm plates are stacked face to face, not end to end (critical section unchanged)
2026-10-26 Report: arm built from plate pairs (6 mm at the hub), safety factors 34 direct / 7.6 with 5:1
2026-10-26 Report: author edits (campaign -> run, schematic text trimmed)
2026-10-26 Report: linear mixing justified by the arm geometry and the measured 1.6 mm/deg; full model kept as reference
2026-10-26 Report: vertical-motion limits rewritten short (drive torque limits bouncing; PET-G only weak against side forces, metal arms)
2026-10-27 TODO: base accelerometer, ordered by priority
